ledwards2/P04-Purple/Demo Day/Marco/renders/Whole_Robot_2020-May-24_08-42-28AM-000_CustomizedView5941647607.png

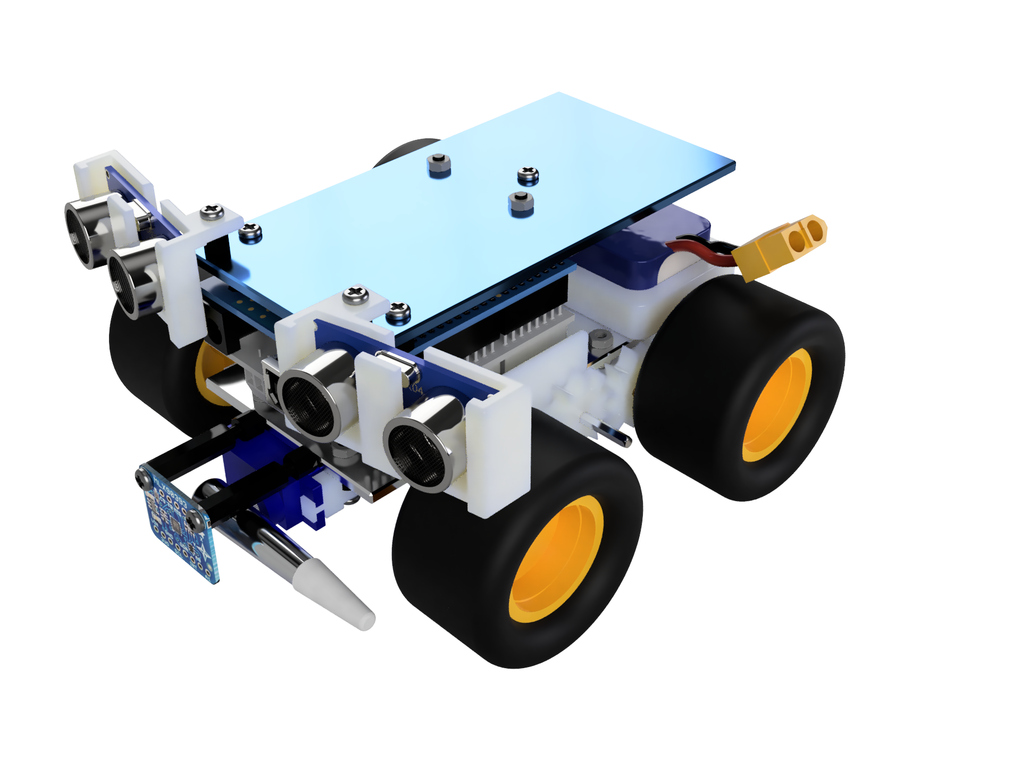
Demo Day/Marco/renders/Whole_Robot_2020-May-24_08-42-28AM-000_CustomizedView5941647607.png
