ledwards2/P04-Purple/Demo Day/Marco/renders/front.PNG

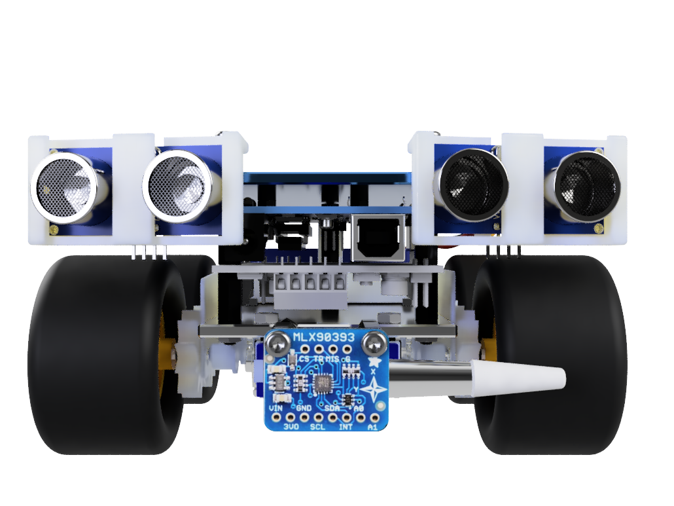
Demo Day/Marco/renders/front.PNG
