ledwards2/P04-Purple/README.md

# P04-Purple
ENGG1100 P04 Purple team repository
