ledwards2/P04-Purple/Code/info.txt

main.ino: main code for robot - to be used on demo day
test_movement.ino: basic code to test movement and turning of robot
test_sensors.ino: basic code to test sensors
