ledwards2/P04-Purple/Milestone_Files/Power System Justification.docx

The robot uses a Tamiya 70097 Twin Motor Gearbox, which uses to Mabuch Motor FA-130RA-18100 Motors (Pololu Corporation, n.d.).

These motors are powered between 1.5 and 3 volts, and at peak efficiency, they consume 0.56A at 9710 RPM. At stall, they consume 2.1A (Mabuchi Motor, n.d).

A 1A constant current draw will be assumed per motor.

A 10 minute total required run time will be assumed, to allow for testing and a five minute measured run.

The Arduino Uno will use around 50mA (http://www.gadgetmakersblog.com/arduino-power-consumption/).

Each ultrasonic sensor uses 15mA while working (https://randomnerdtutorials.com/complete-guide-for-ultrasonic-sensor-hc-sr04/), so a 30mA current draw for ultrasonic sensors is assumed. The Melexis MLX90393 Magnetometer uses a nominal current of 100 microamps (Melexis, 2020).

The marking system servo uses 100mA while moving with no load, which is similar to the desired use, where the servo motor moves only a paint brush. (https://www.addicore.com/FS90-Mini-Servo-p/ad113.htm)

The total current:

I_(total) =I_(motors) +I_(arduino) +I_(sensors) +I_(marking)

I_(motors) =2 , I_(arduino) =0.05 , I_(sensors) =0.015×2+0.0001=0.0301 and I_(marking) =0.1

The constant current draw is:

I_(total) =2+0.05+0.0301+0.1=2.1801

10 minute drive time is 1/6 hours

2.1801×1/6=0.36335Ah

The battery must supply at least 0.365335 amp-hours. The Arduino input voltage is from 7 to 12 volts and the motorshield input voltage is from 5 to 12 volts. A voltage input between this range must be supplied.

A 2 cell lithium polymer battery will be used. These have a voltage range from 8.4 to 6 volts, with a nominal voltage of 7.4. The required capacity is 364mAh. An 800mAh battery will be used, to allow extra headroom for variation from calculations, and since its weight is still low (59g).

Available at:

https://hobbyking.com/en_us/turnigy-800mah-2s-40c-lipo-pack.html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

It is important to note that the supplied motors and motor controller are not explicitly compatible, since the motors work at a lower voltage range than the motorshield. Where the input voltage is 8.4V:

3=8.4×%_(pwm)

%_(pwm) =36

Where an input PWM duty cycle 36% or over is input, the motor voltage range is exceeded, so this must be the maximum PWM input in software. The PWM voltage spikes should not pose any issue for motor longevity as the inductive quality of motor windings will smooth these out.
