ledwards2/P04-Purple/Milestone_Files/Drive system sketches.pdf

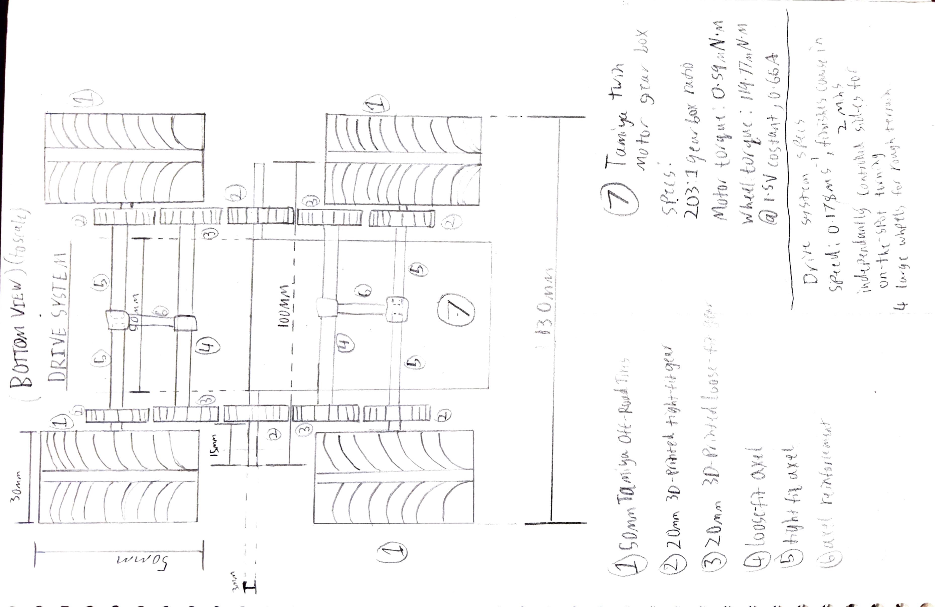
[picture p20: page 1]
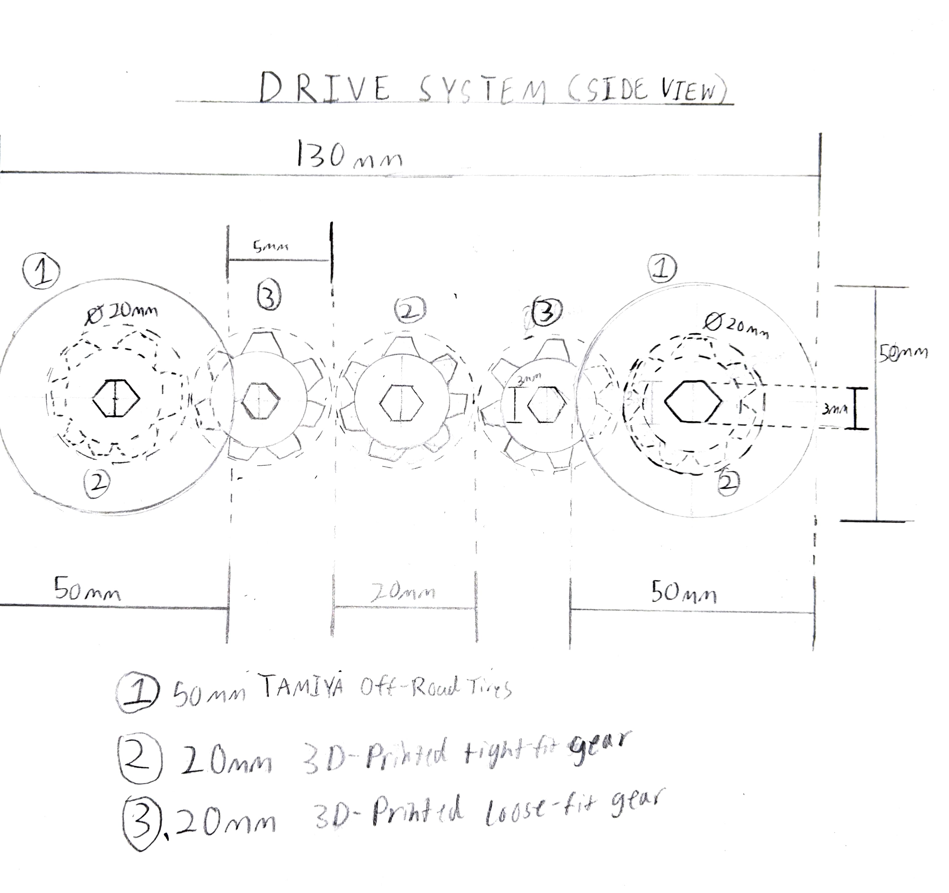
[picture p21: page 2]
