ledwards2/P04-Purple/Milestone_Files/centre of gravity calqs.pdf

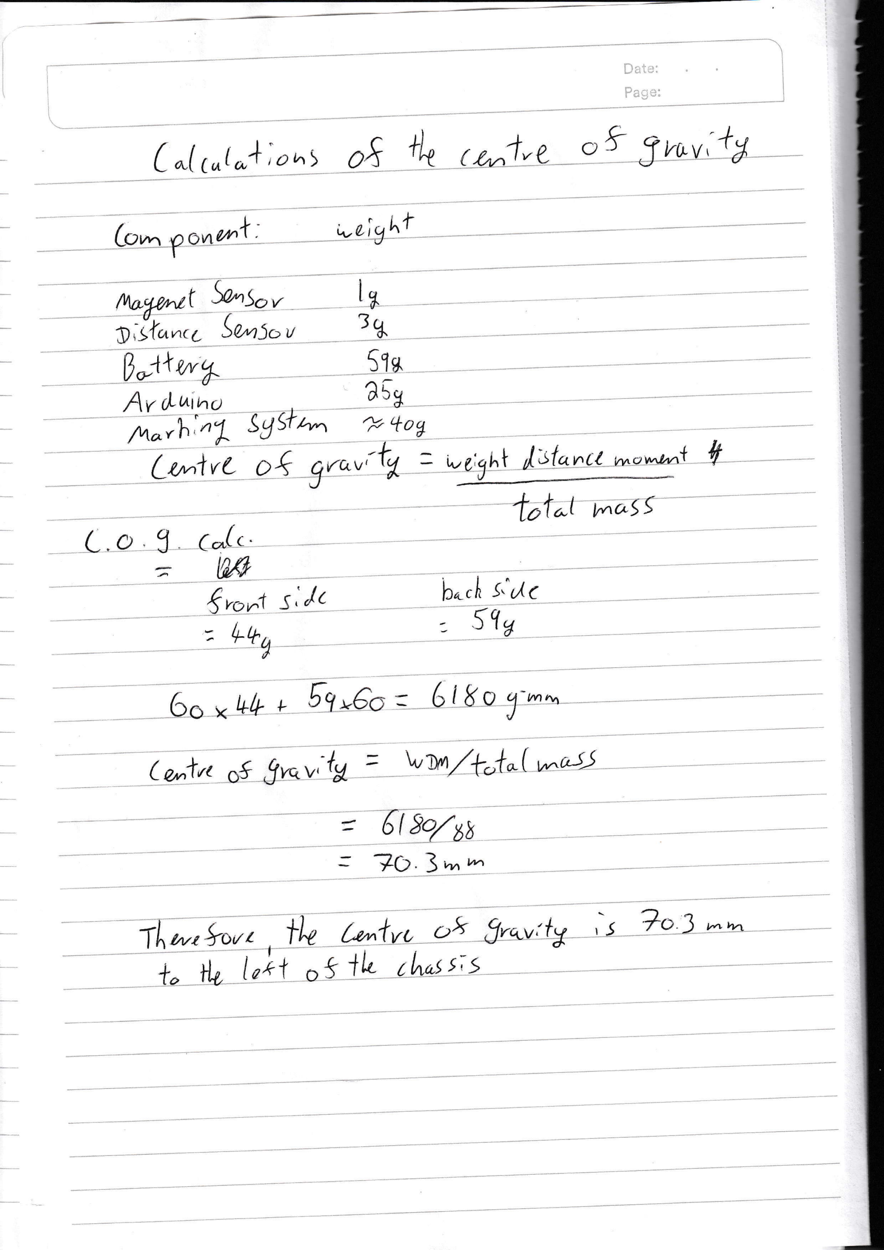
[picture p22: page 1]

D*l:;: | l
Pa!1,': | .-]
(*(u[*4)oa\ | o * ? ruv,"+,

Avd-t^inc) - .i--Jr
A;,T;T sgT?_k,+et

### -tat*-m"rr

---6s-xll*--6:,go-=*b!8*o-yr^-

VO-3^^

ln*t

t.^+ | s*
1l* | 5,
