ledwards2/P04-Purple/Milestone_Files/Marking System.pdf

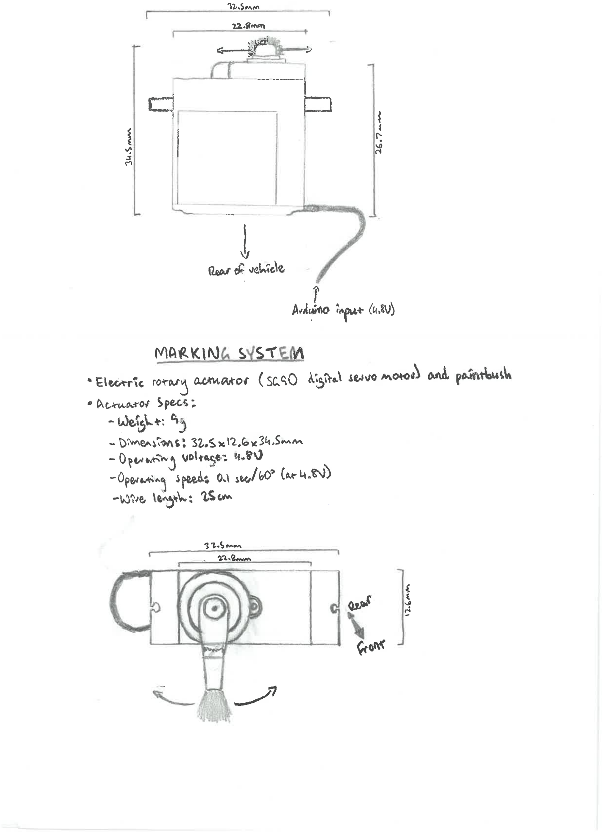
[picture p23: page 1]
