ledwards2/P04-Purple/Demo Day/Marco/renders/side.PNG

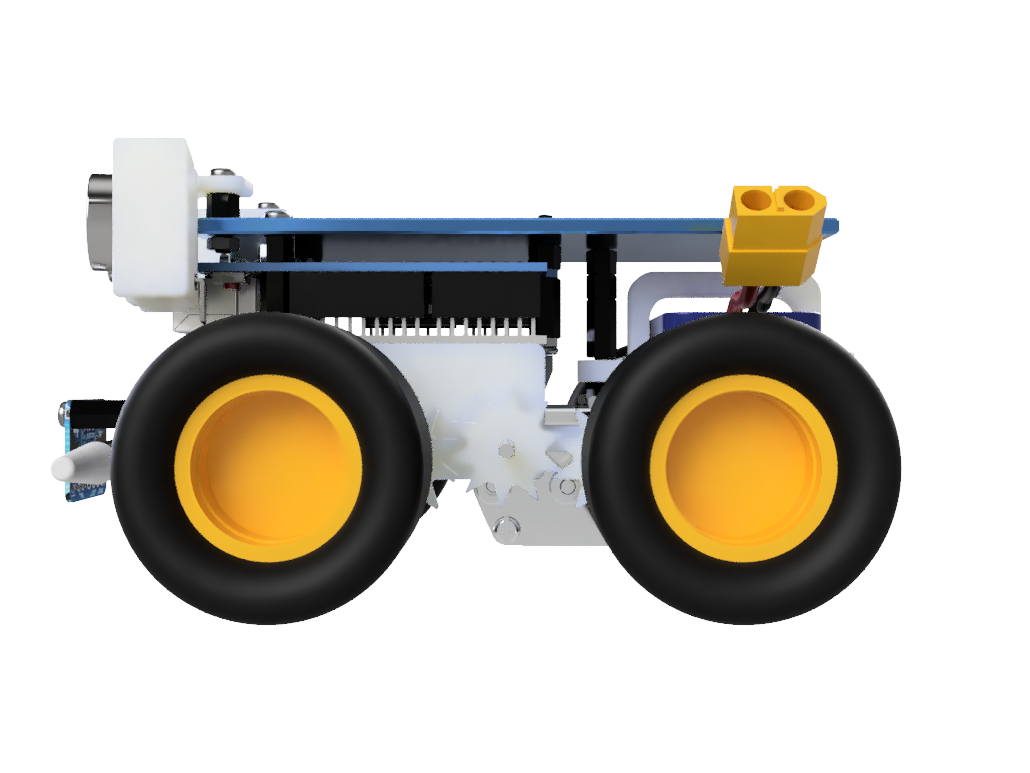
Demo Day/Marco/renders/side.PNG
