ledwards2/P04-Purple/Demo Day/Marco/renders/Whole_Robot_2020-May-28_04-46-54AM-000_CustomizedView5582573335.png

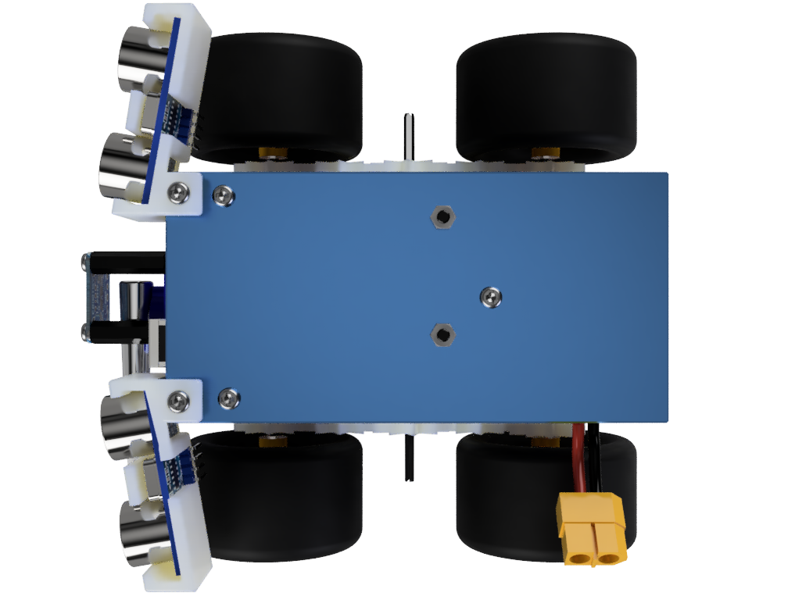
Demo Day/Marco/renders/Whole_Robot_2020-May-28_04-46-54AM-000_CustomizedView5582573335.png
