ledwards2/P04-Purple/Milestone_Files/Circuit Digram.png

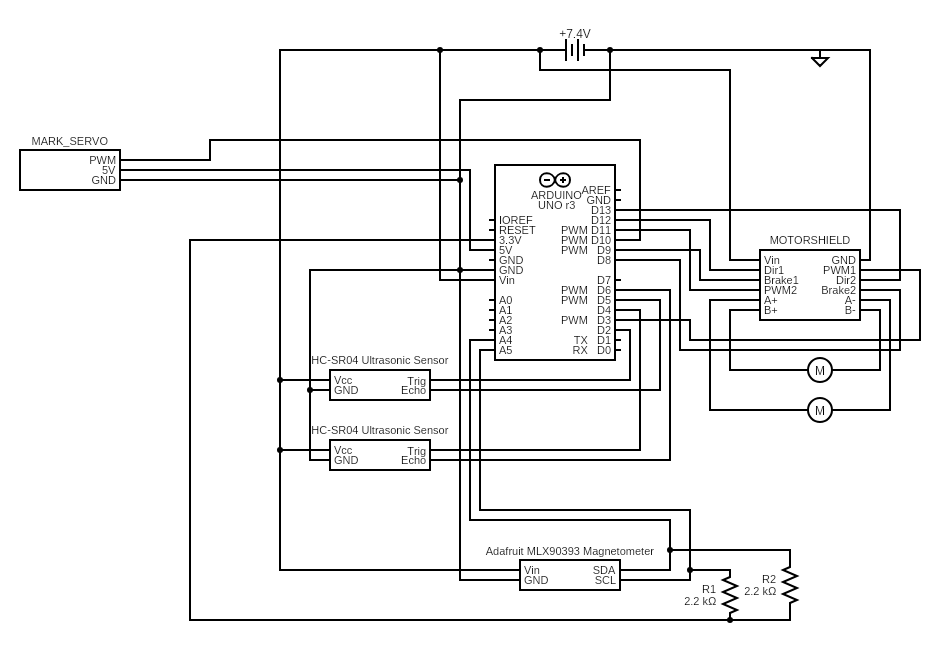
Milestone_Files/Circuit Digram.png
