ledwards2/P04-Purple/Milestone_Files/gear iso.png

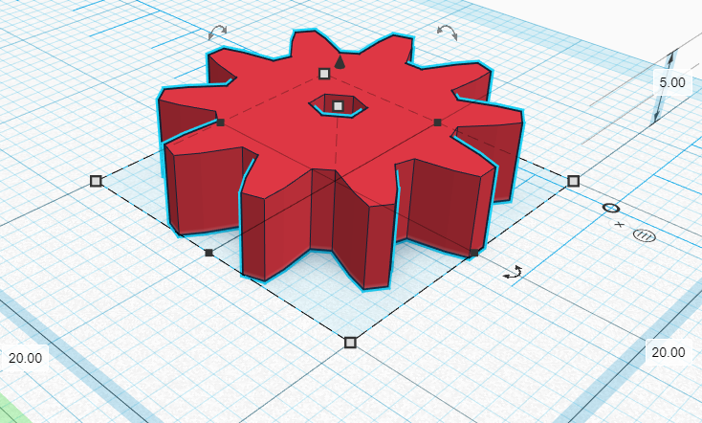
Milestone_Files/gear iso.png
