ledwards2/P04-Purple/Milestone_Files/gear top.png

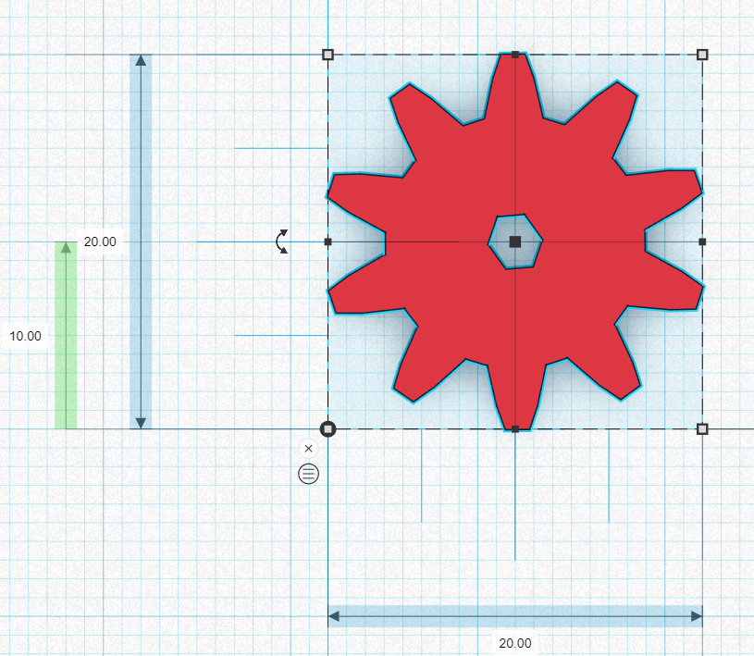
Milestone_Files/gear top.png
