ledwards2/P04-Purple/Milestone_Files/Layout Diagram.png

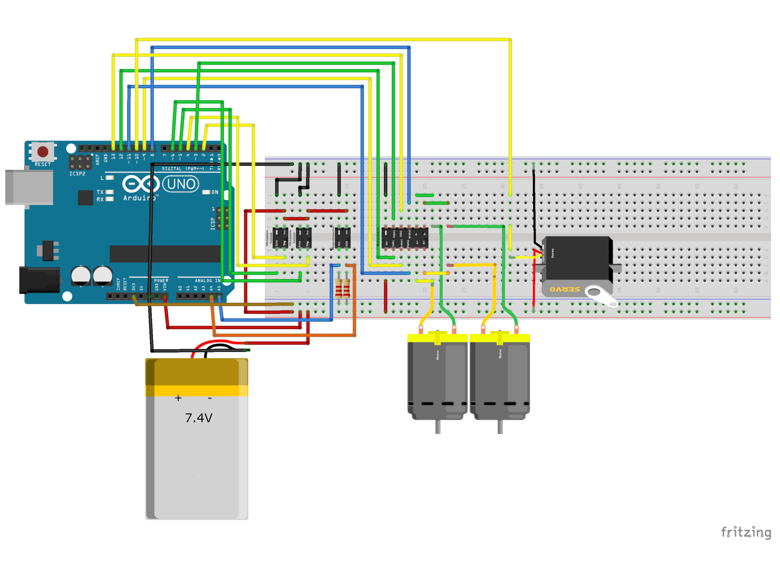
Milestone_Files/Layout Diagram.png
