ledwards2/P04-Purple/Gantt Chart and Resource Allocation.xlsx

TASK/SUBTASK |  | RESOURCES |  | 6 April, Wk 6 |  |  |  |  |  | 20 April, Wk 7 |  |  |  |  |  | 27 April, Wk 8 |  |  |  |  |  | 4 May, Wk 9 |  |  |  |  |  | 11 May, Wk 10 |  |  |  |  |  | 18 May, Wk 11 |  |  |  |  |  | 25 May, Wk 12 |  |  |  |  |  | 1 June, Wk 13
No. | Description | Hours | Who | M | T | W | T | F | S/S | M | T | W | T | F | S/S | M | T | W | T | F | S/S | M | T | W | T | F | S/S | M | T | W | T | F | S/S | M | T | W | T | F | S/S | M | T | W | T | F | S/S | M | T | W | T | F | S/S
1 | Basic Planning/Administrative Phase | 9
1.1 | Compare PIRs and establish design | 3 | Team
1.2 | Establish team roles | 1 | Team
1.3 | Distribute roles to best fit team member | 1 | Team
1.4 | Basic design sketch | 3 | Joseph
1.5 | Allocate budget | 1 | Team
2 | Subsystem Design Phase | 35
2.1 | Develop WBS for each subsystem | 2 | Team
2.2 | Marking system design | 9
2.2.1 | Choose marker type | 2 | Joseph
2.2.2 | Rough physical design | 1 | Joseph
2.2.3 | Choose components | 3 | Joseph
2.2.4 | CAD drawing of design | 3 | Joseph
2.3 | Mechanical Design | 7
2.3.1 | Research provided gearbox | 1 | Abhishekh
2.3.2 | Choose travelling method | 1 | Abhishekh
2.3.3 | Choose appropriate materials for chassis | 1 | Luke
2.3.4 | Design chassis | 2 | Luke
2.3.5 | Choose components and write specification | 2 | Abhishekh
2.4 | Electrical Design | 5
2.4.1 | Research provided sensors | 1 | Lachlan
2.4.2 | Choose power system | 1 | Abhishekh
2.4.3 | Choose sensors | 1 | Joseph
2.4.4 | Circuit diagram for whole robot | 2 | Luke
2.5 | Software | 12
2.5.1 | Choose search algorithm | 2 | Lachlan
2.5.2 | Write function to communicate with sensors | 4 | Lachlan
2.5.3 | Choose activation threshold for sensors | 1 | Lachlan
2.5.4 | Write main code | 5 | Lachlan
3 | Subsystem Integration Phase | 7
3.1 | Bring subsystem designs together | 7
3.1.1 | Consider component interconnections | 3 | Team
3.1.2 | Modify so that subsystems work together | 4 | Team
4 | Purchasing Phase | 4
4.1 | Write parts list for whole robot | 1 | Joseph
4.2 | Check all costs are within budget | 1 | Luke
4.3 | Modify component selection if needed | 2 | Team
5 | Build Phase | 19
5.1 | Develop WBS for build process | 1 | Luke
5.2 | Build as per breakdown | 10 | Team
5.3 | Test components individually | 5 | Team
5.4 | Connect components together | 3 | Team
6 | Testing Phase | 8
6.1 | Test in environment similar to Demo Day | 4 | Team
6.2 | Modify or redesign as needed | 4 | Team
M | Team Meetings | 2/wk |  |  |  |  |  |  |  |  |  |  |  |  |  |  |  |  |  |  |  |  |  |  |  |  |  |  |  |  |  |  |  |  |  |  |  |  |  |  |  |  |  |  |  | DD |  |  | FR
M | Submission Due | N/A |  |  |  | PSP |  |  |  |  |  |  |  |  |  |  |  |  |  |  |  |  |  | MT |  |  |  |  |  |  | LB
M | Templates | 1/pt |  | F |  |  |  |  |  | G |  |  | H |  |  | I |  |  | J |  |  | K
