ledwards2/P04-Purple/WBS - 3 Apr.xlsx

Work Breakdown Structure
SAP PROJECT SYSTEM |  |  |  |  |  |  |  |  |  |  |  | OTHER PROJECT TOOLS
Level 1 WBS |  |  |  |  |  | Autonomous Landmine Sweeper
Level 2 WBS | Basic Planning / administrative Phase | Subsystem Design Phase | Marking System Design Phase | Drive System Design Phase | Sensors Design / Electrical Configuration | Software | Subsystem Integration Phase | Purchasing Phase | Build Phase | Testing Phase | Project Name
Level 3 WBS | Preliminary Work Plan | Design of discipline specific parts | Choose marker type | Research provided motor/gearbox | Research provided sensors | Choose search algorithm | Compare design plans/CAD models and collaborate | Write parts list for whole robot | Person/people responsible for each role build respective component | Test robot with all subsystems connect, in environments similar to demo day | Phase
 | Compare PIRs | Refer to relevant PIR | Rough physical design of marking system | Choose propulsion type - wheels, tracks, etc | Choose power system, voltage regulator (if needed) | Write function to communicate with sensors | Consider interconnections between components eg. Communication protocol | Check all costs are within budget | Develop breakdown of build work to be completed | Test with similar environments to Demo Day eg. With magnets, walls,
 |  |  |  |  |  |  |  |  |  |  | Task
 | Establish Team Roles | Develop WBS for task eg. Software WBS | Choose actuator and electrical components | Work with chassis developer for wheel spacing etc | Choose sensors | Choose activation threshold for sensors | Make necessary modifications so that subsystems work together as needed | Modify component selection if needed | Build as per breakdown | Make modifications or redesign as necessary
 | Distribute roles to best fit team member | Design as per specific WBS | CAD design of marking system | Choose components and write specification for drive system | Circuit diagram for whole robot | Write main code |  |  | Test components individually
 | Basic Design Sketch | Develop CAD model or software code |  |  |  |  |  |  | Connect components together
 | Allocate budget
