ledwards2/P04-Purple/Milestone_Files/Wiring-layout-3.pdf

1

A

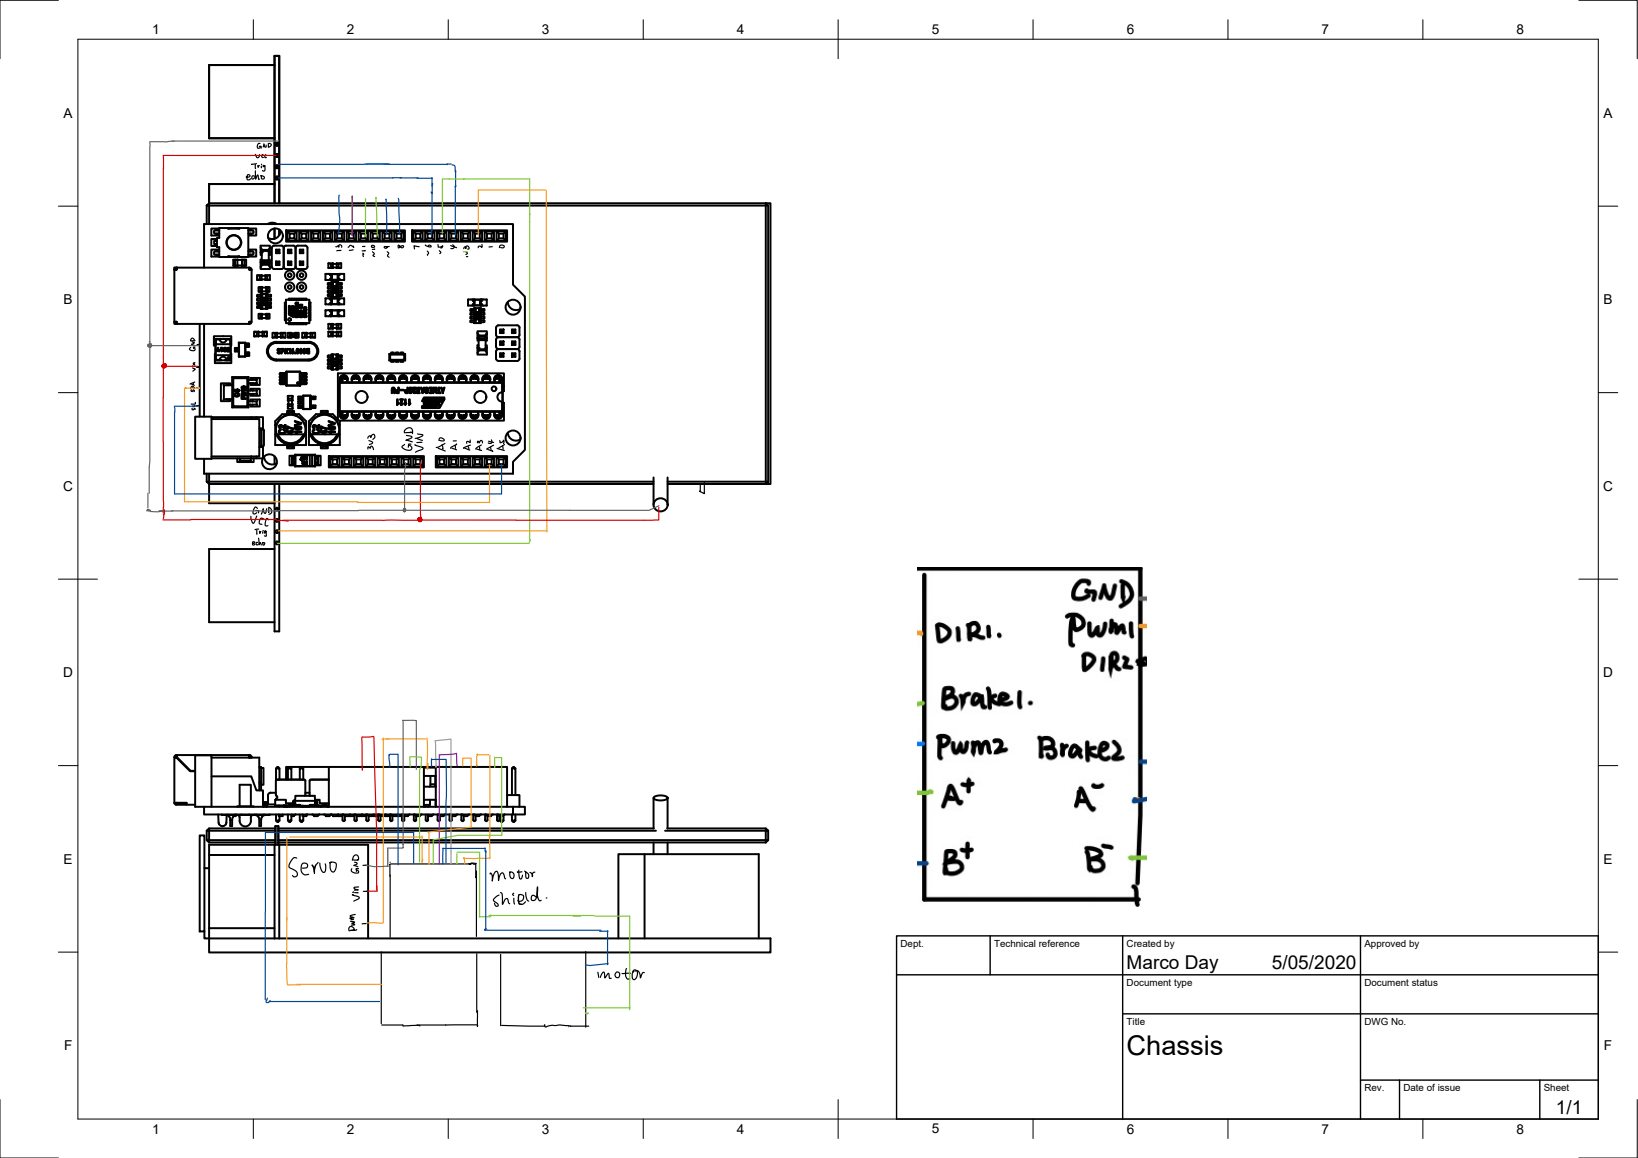
[picture p30: page 1]
Dept.; Technical reference; Created by; Approved by; Document type; Document status; Marco Day; iii.÷; # motor

Title Chassis | DWG No.

Rev. | Date of issue | Sheet 1/1
