ledwards2/P04-Purple/Milestone_Files/Wiring-layout-2.pdf

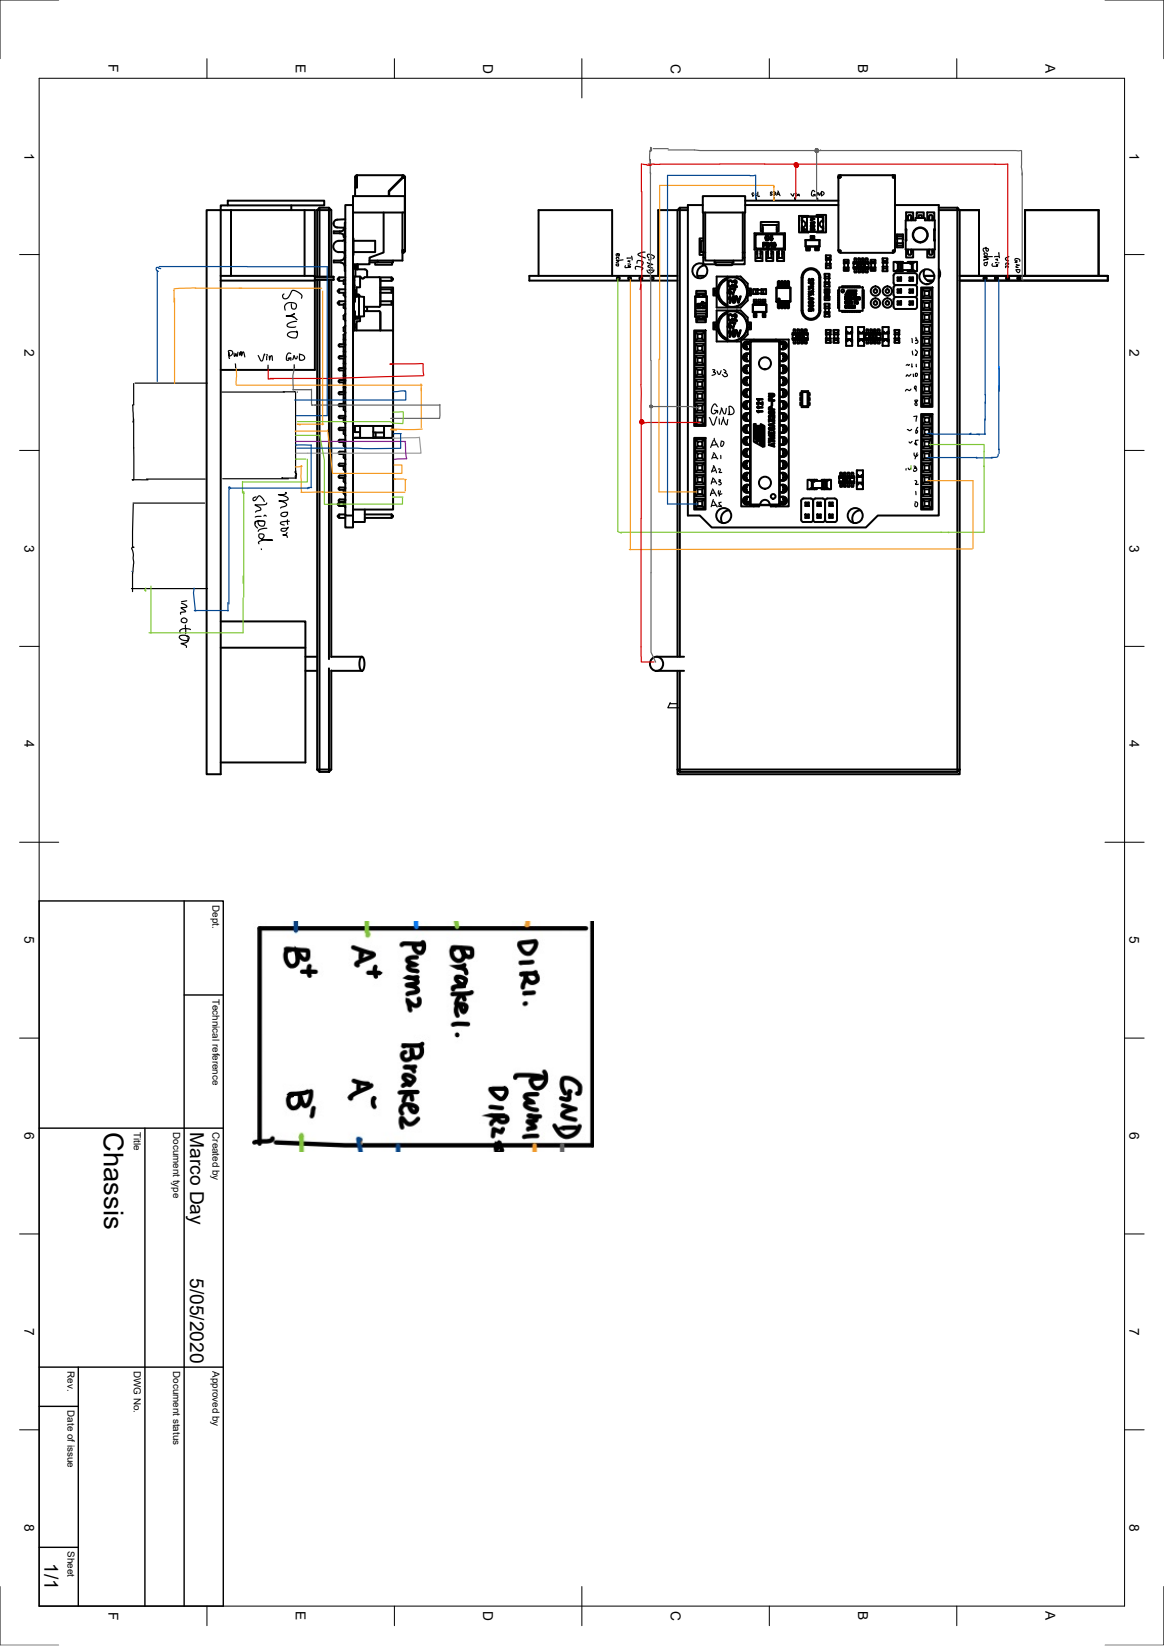
[picture p31: page 1]
Title; Rev.; DWG No.; Chassis; Marco Day; # motor

Dept. Technical reference Created by Approved by

Document type Document status

Date of issue Sheet
