ledwards2/P04-Purple/Demo Day/Marco/Chassis Drawing.pdf

19 | 20.5 | 7.85 62.9 1 5.75 9.15 61.6

29 15.5

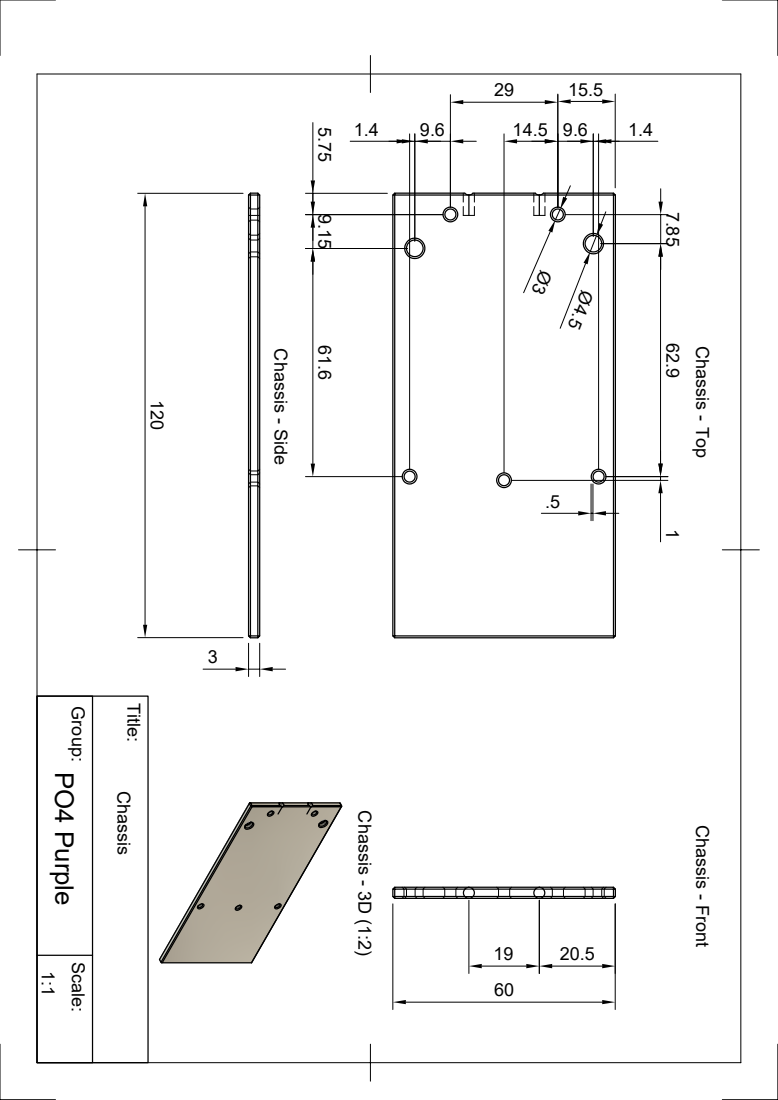
[picture p32: page 1]
60 ¹²⁰; .5 Chassis - Side; Chassis - Front Chassis - Top Chassis - 3D (1:2)

Group: Scale: Title: PO4 Purple Chassis 1:1
