ledwards2/P04-Purple/Milestone_Files/Battery Dimensions.pdf

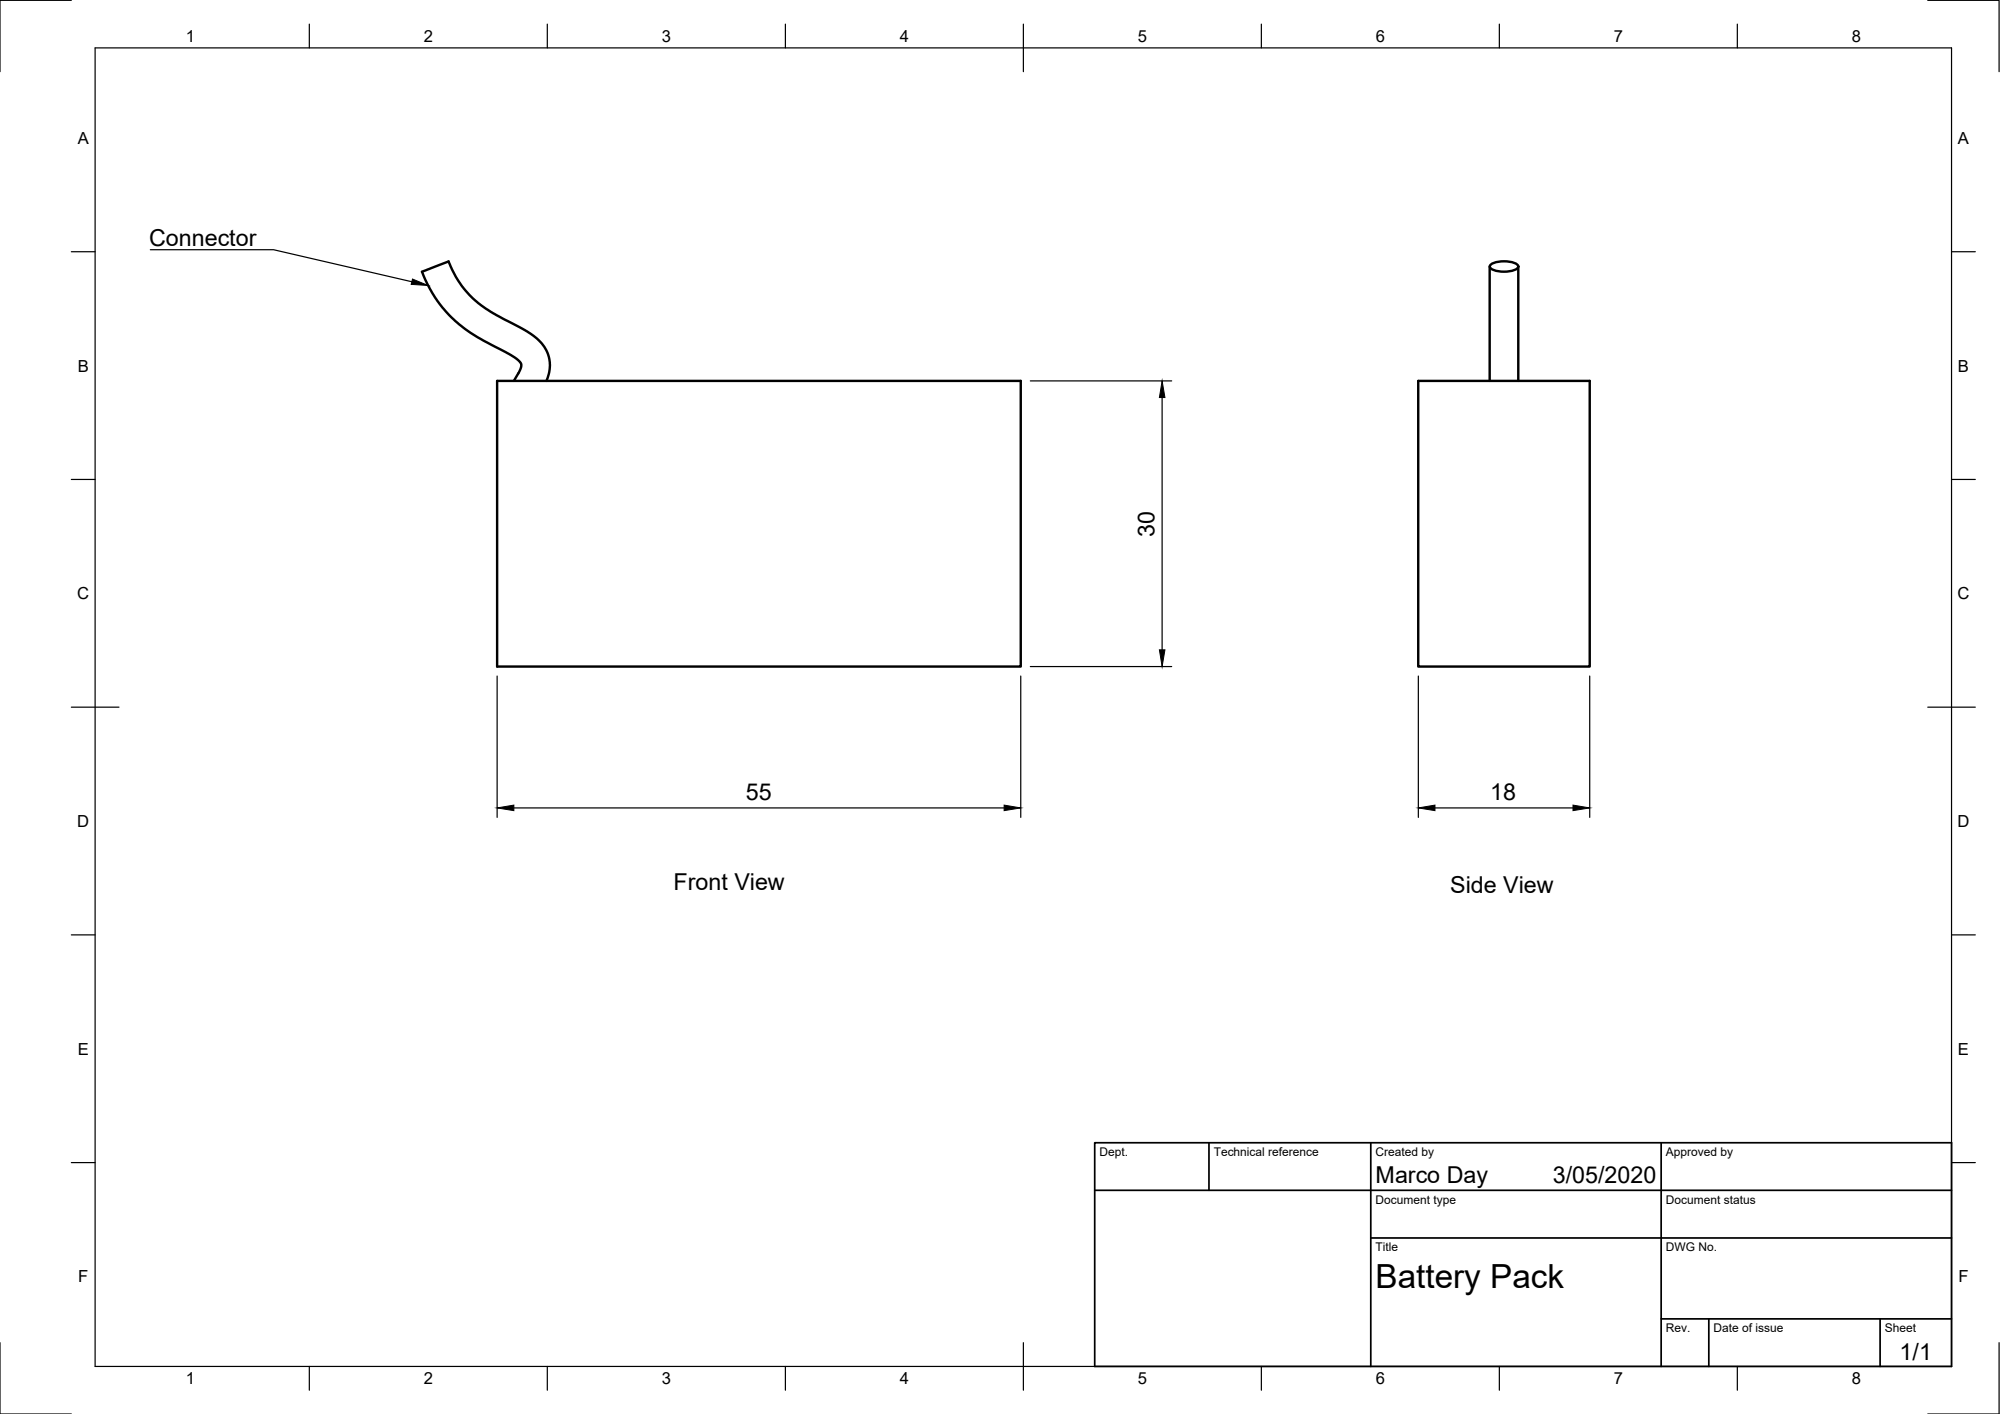
[picture p34: page 1]
Front View; Side View

Dept. | Technical reference | Created by Marco Day 3/05/2020 | Approved by

Document type | Document status

Title Battery Pack | DWG No.

Rev. | Date of issue | Sheet 1/1
