ledwards2/P04-Purple/Milestone_Files/Magnetometer Dimensions.pdf

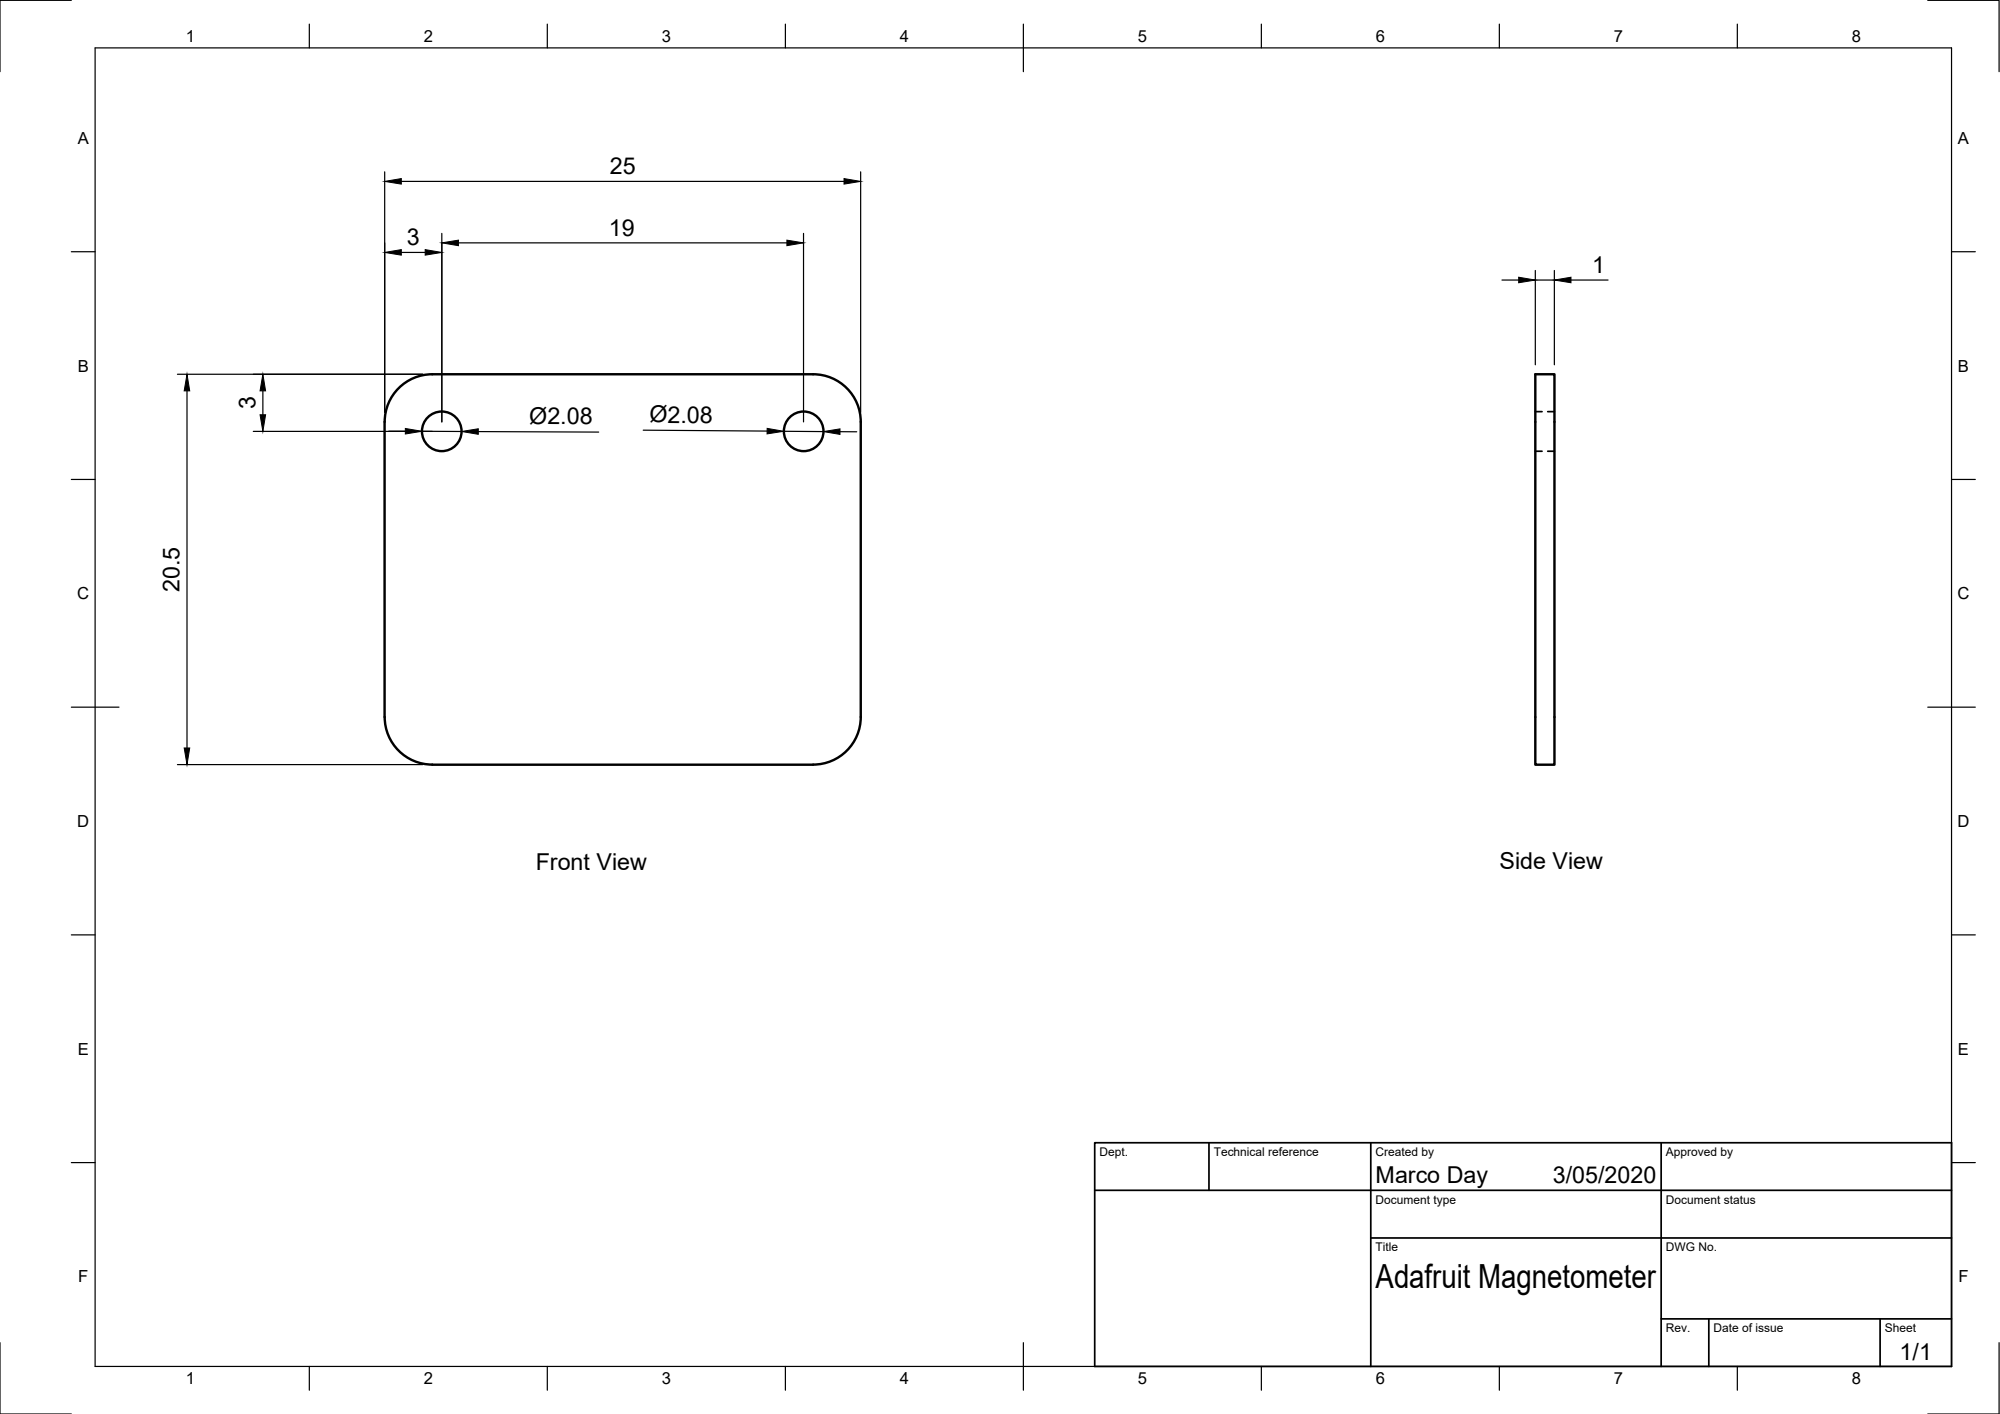
[picture p35: page 1]
Front View; Side View

Dept. | Technical reference | Created by Marco Day 3/05/2020 | Approved by

Document type | Document status

Title Adafruit Magnetometer | DWG No.

Rev. | Date of issue | Sheet 1/1
