ledwards2/P04-Purple/Milestone_Files/Ultrasonic Dimensions.pdf

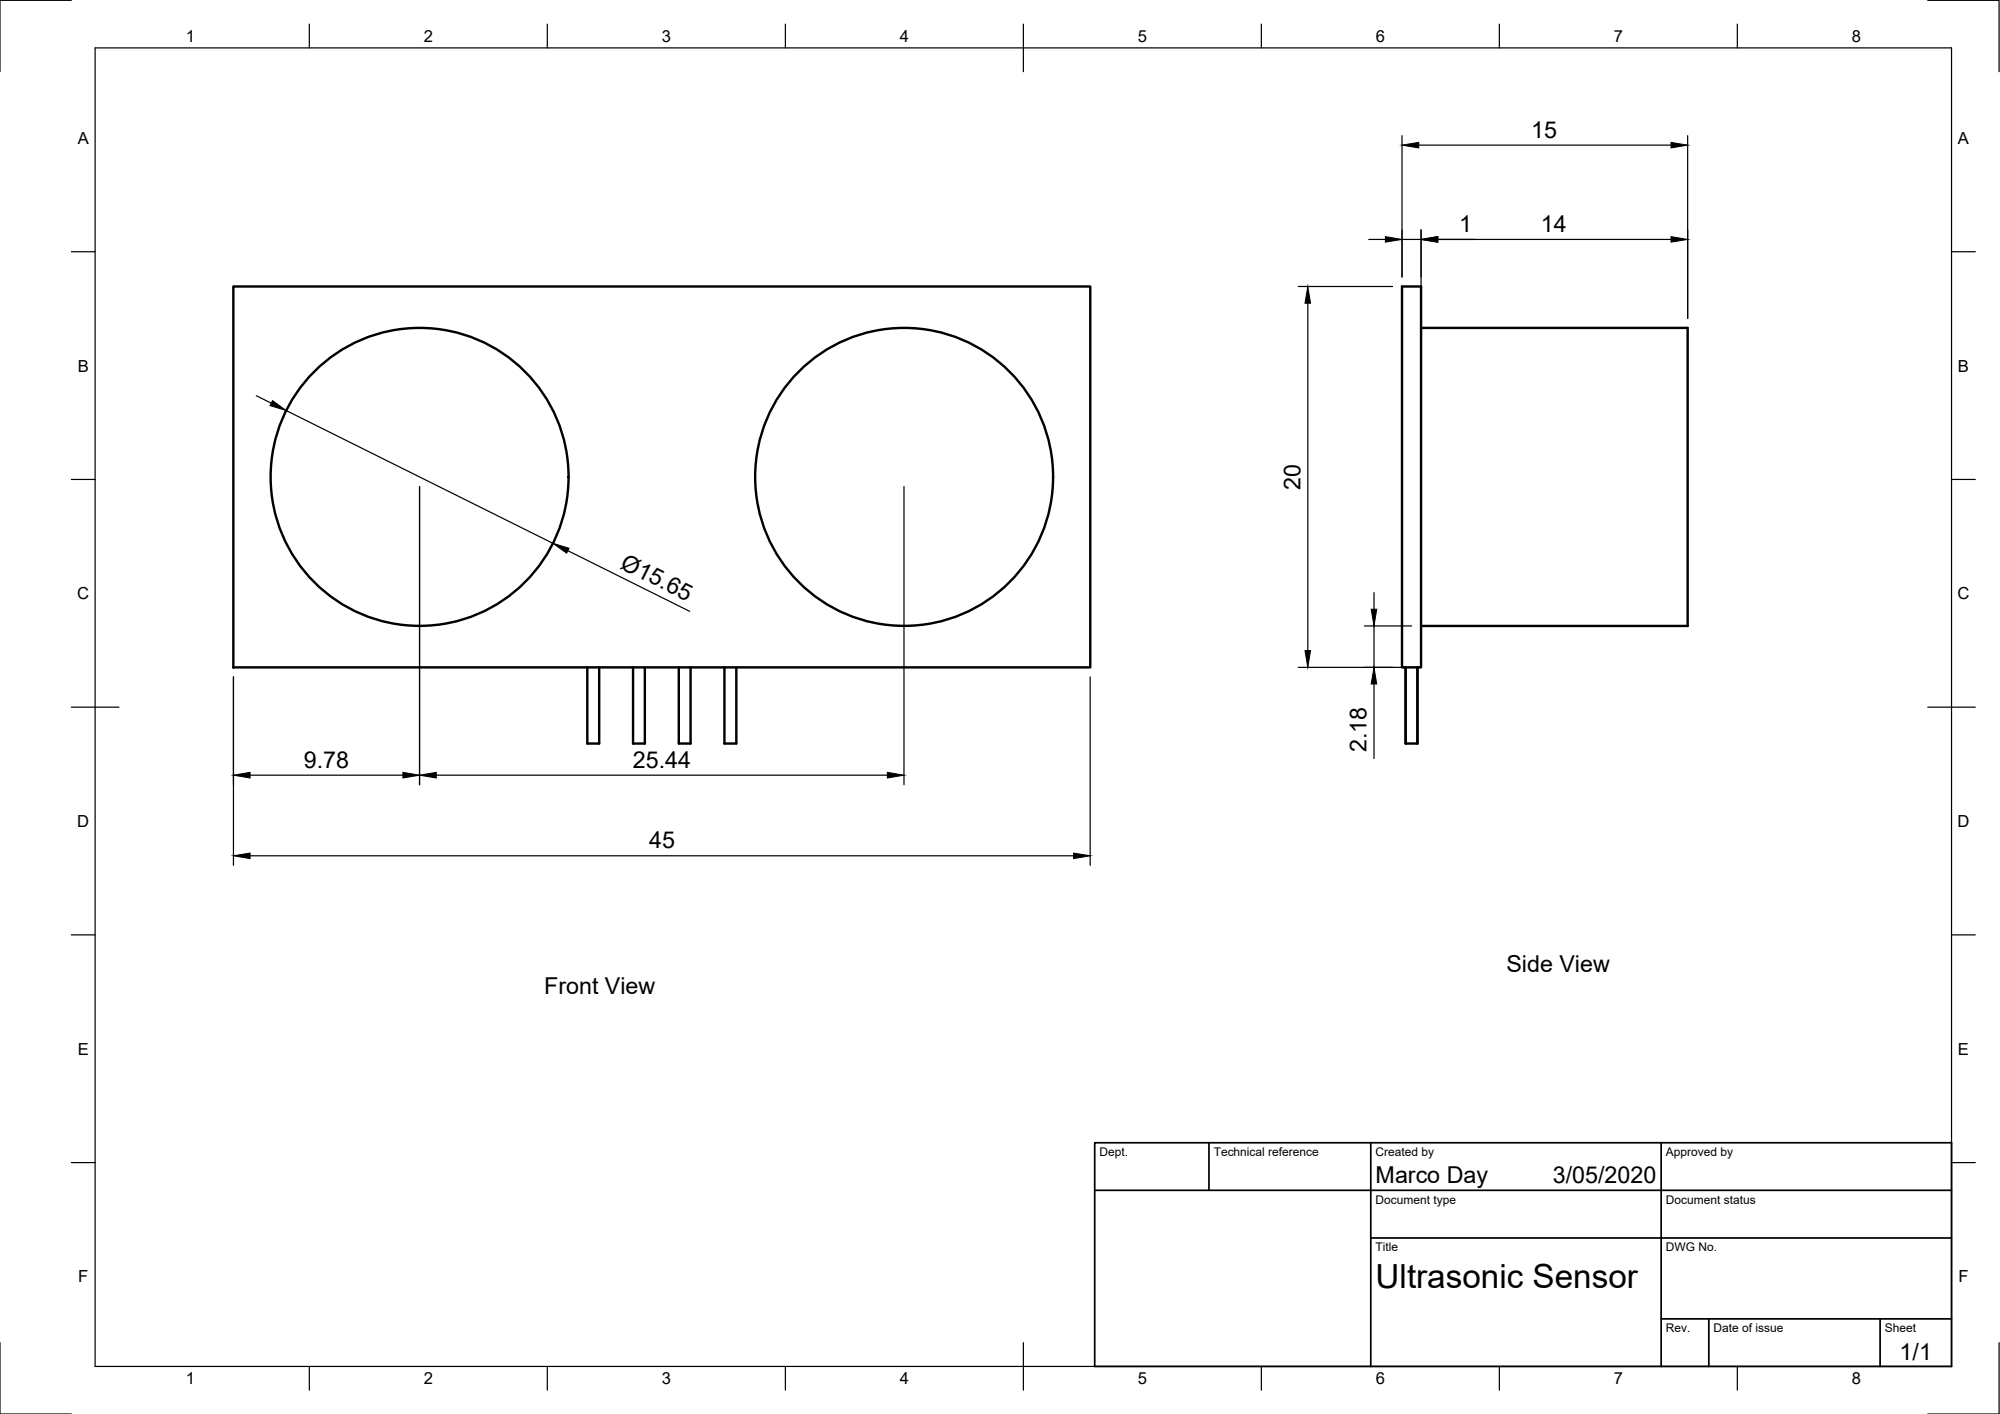
[picture p36: page 1]
Side View; Front View

Dept. | Technical reference | Created by Marco Day 3/05/2020 | Approved by

Document type | Document status

Title Ultrasonic Sensor | DWG No.

Rev. | Date of issue | Sheet 1/1
