ledwards2/P04-Purple/Demo Day/Marco/Ultrasonic Sesnsor Bundle Drawing.pdf

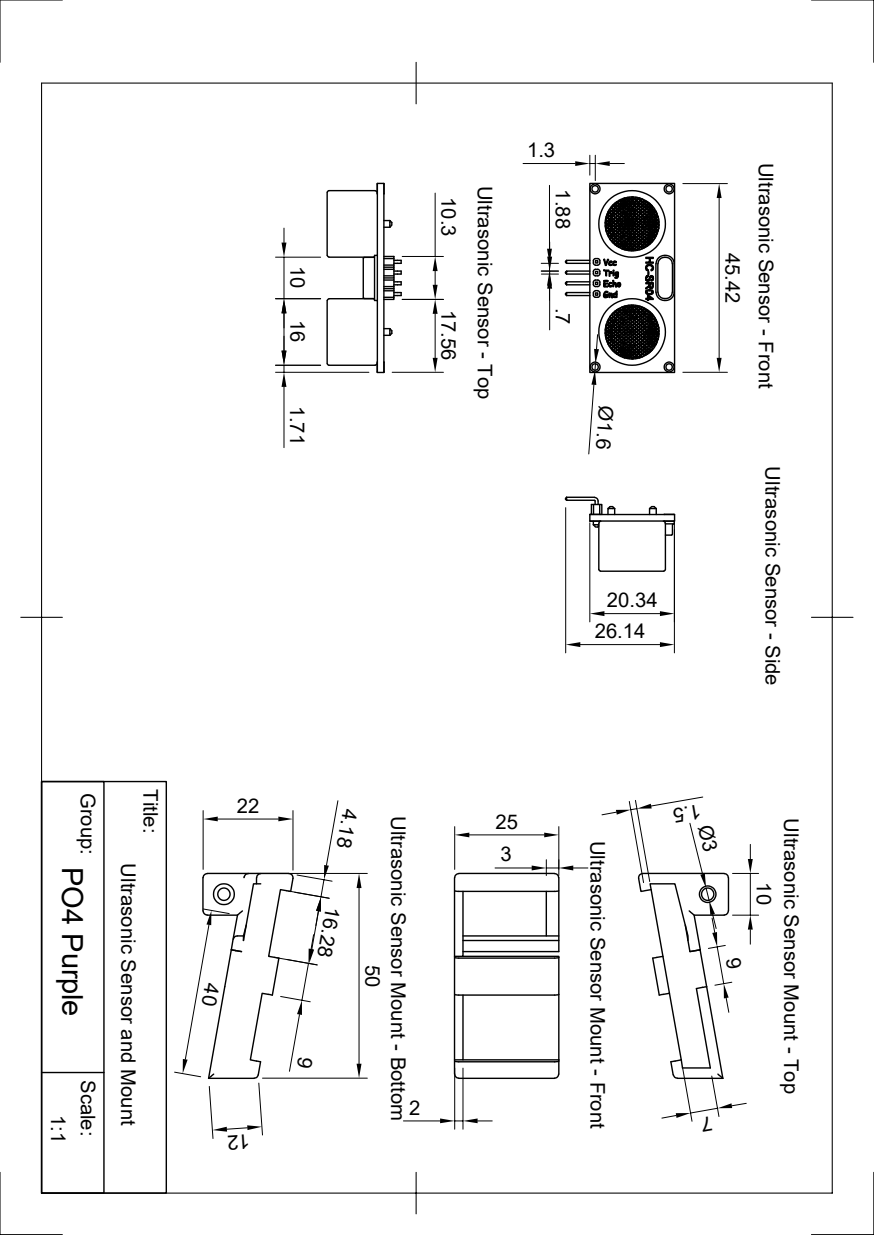
[picture p37: page 1]
Ultrasonic Sensor Mount - Top Ultrasonic Sensor Mount - Front Ultrasonic Sensor Mount - Bottom; Ultrasonic Sensor - Top; Ultrasonic Sensor - Front Ultrasonic Sensor - Side 1:1; Ultrasonic Sensor and Mount

Group: Scale: Title: PO4 Purple 50 16.28 9
