ledwards2/P04-Purple/Demo Day/Marco/Bottom.pdf

.97 18.78 41.6 7

8.97

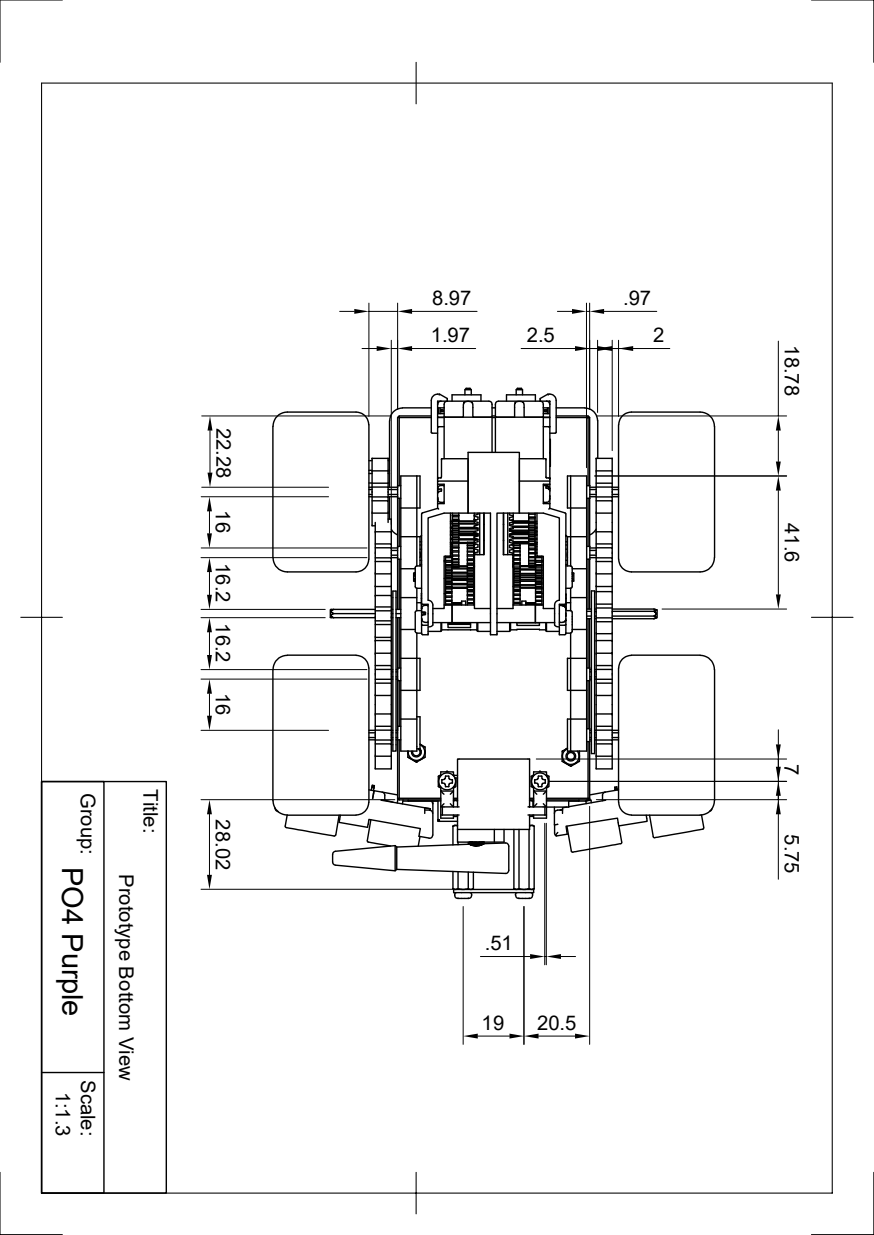
[picture p38: page 1]

Group: Scale: Title: PO4 Purple 1:1.3 Prototype Bottom View 5.75
