ledwards2/P04-Purple/Demo Day/Marco/Drive System.pdf

20 5 | Ø25 1

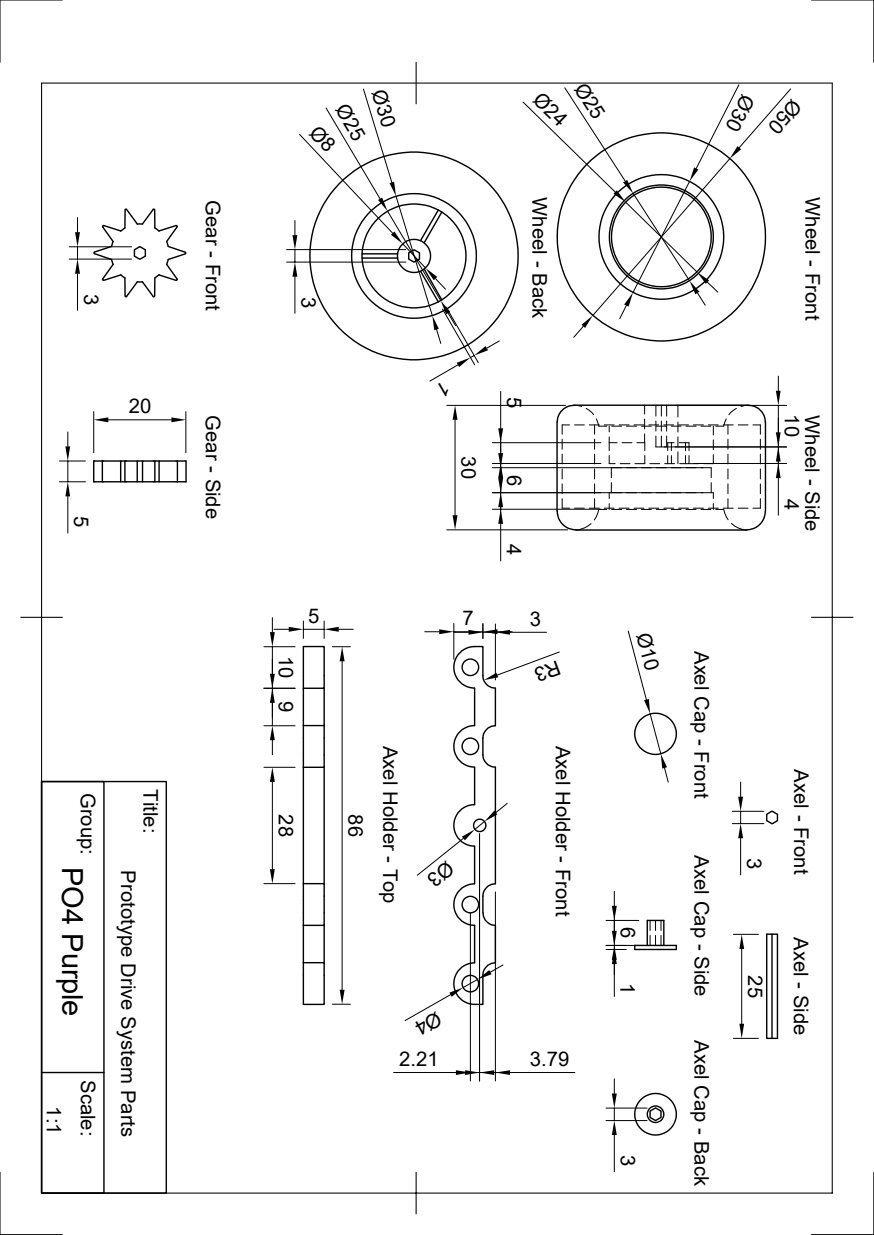
[picture p39: page 1]
Wheel - Front 1; Wheel - Side Wheel - Back Axel Holder - Top; Axel Holder - Front; Axel - Front Axel - Side 3 25 Ø10 6 3; Axel Cap - Front Axel Cap - Side Axel Cap - Back Gear - Front Gear - Side 3

Group: Scale: Title: PO4 Purple Ø24 Ø30 Ø50 30 Ø30 Ø25 Ø8 3 10 4 6 4 5 1:1 Prototype Drive System Parts Ø4 Ø3 R3
