ledwards2/P04-Purple/Demo Day/Marco/Side.pdf

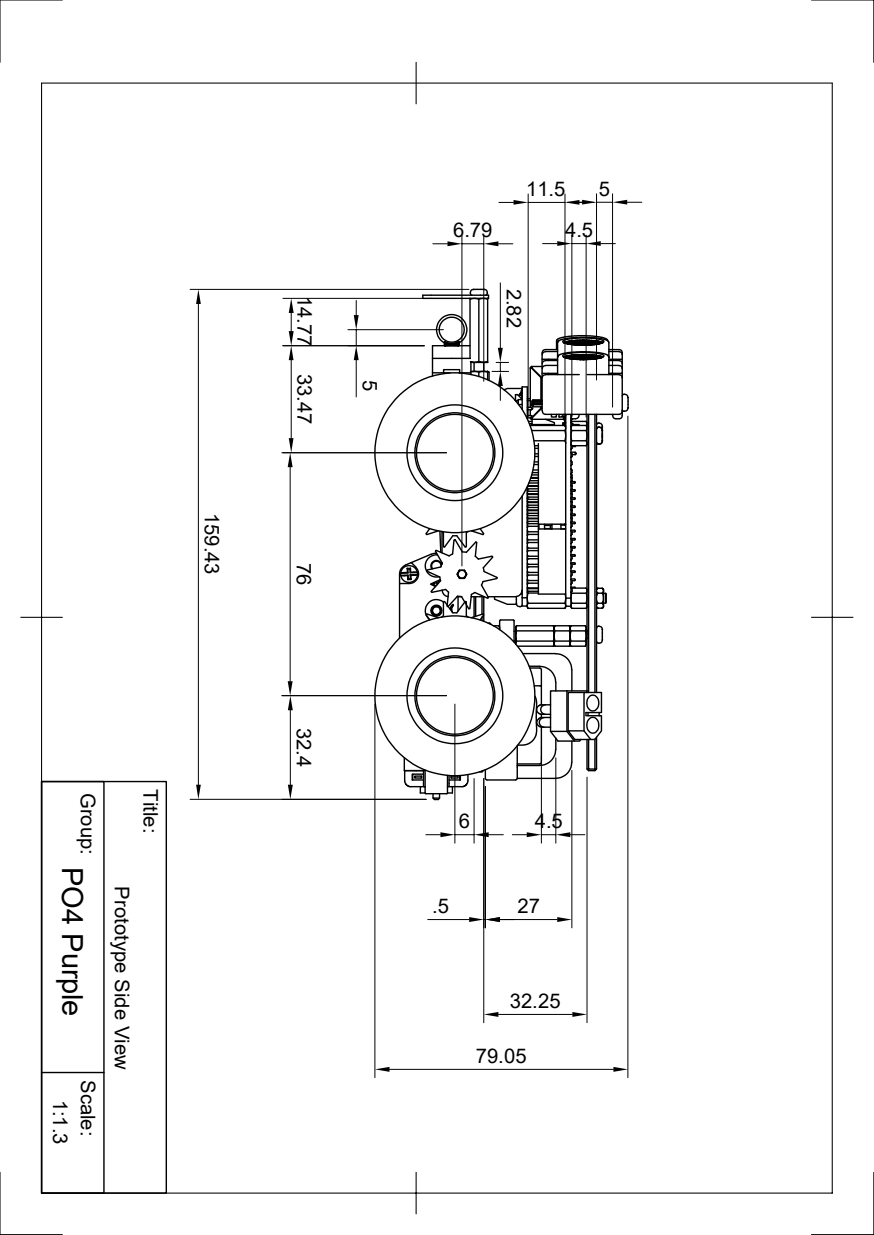
[picture p40: page 1]

Group: Scale: Title: PO4 Purple 159.43 1:1.3 Prototype Side View
