ledwards2/P04-Purple/Demo Day/Marco/Top.pdf

5.9 10°

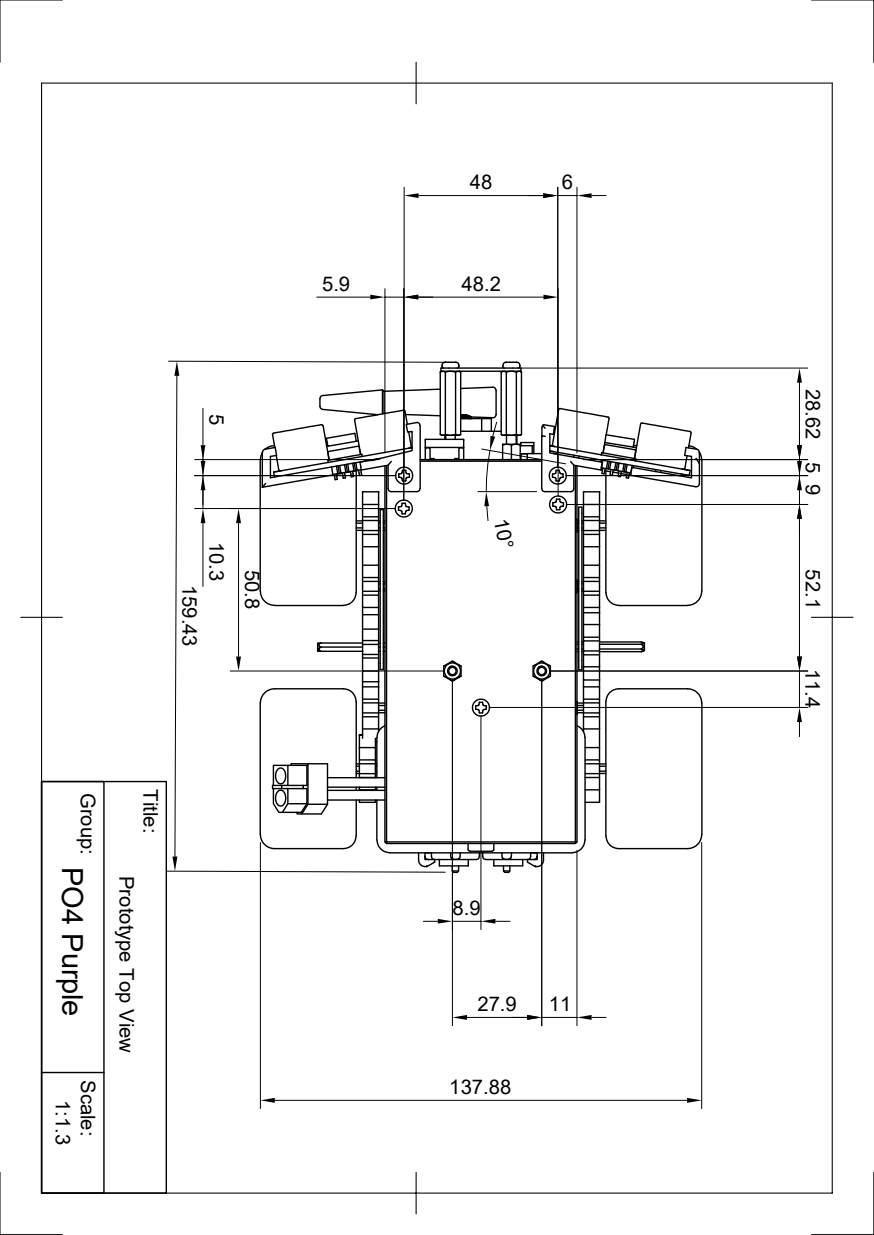
[picture p41: page 1]

Group: Scale: Title: PO4 Purple 159.43

8.9 Prototype Top View 1:1.3
