ledwards2/P04-Purple/Demo Day/Marco/Drawings/Drawing_arduino_and_motor_shield.pdf

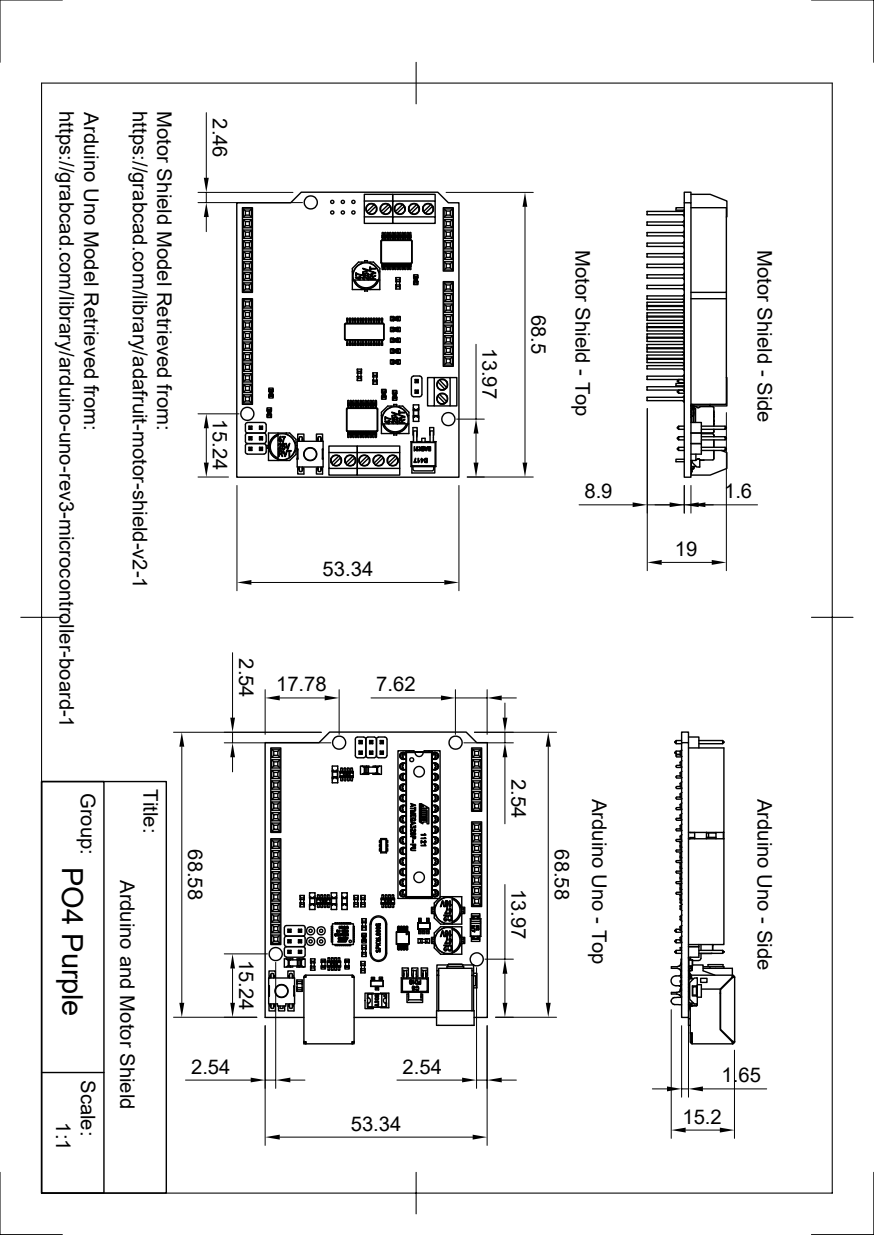
[picture p42: page 1]
15.2 Arduino and Motor Shield; 1.6 Motor Shield - Top; Motor Shield - Side Arduino Uno - Top; Arduino Uno - Side https://grabcad.com/library/arduino-uno-rev3-microcontroller-board-1 Arduino Uno Model Retrieved from:; https://grabcad.com/library/adafruit-motor-shield-v2-1 Motor Shield Model Retrieved from:

Group: Scale: Title: PO4 Purple 68.58 2.54 13.97 2.54 15.24
