ledwards2/P04-Purple/Demo Day/Marco/Drawings/Drawing_Battery_system.pdf

# 18 R5

30 16.7

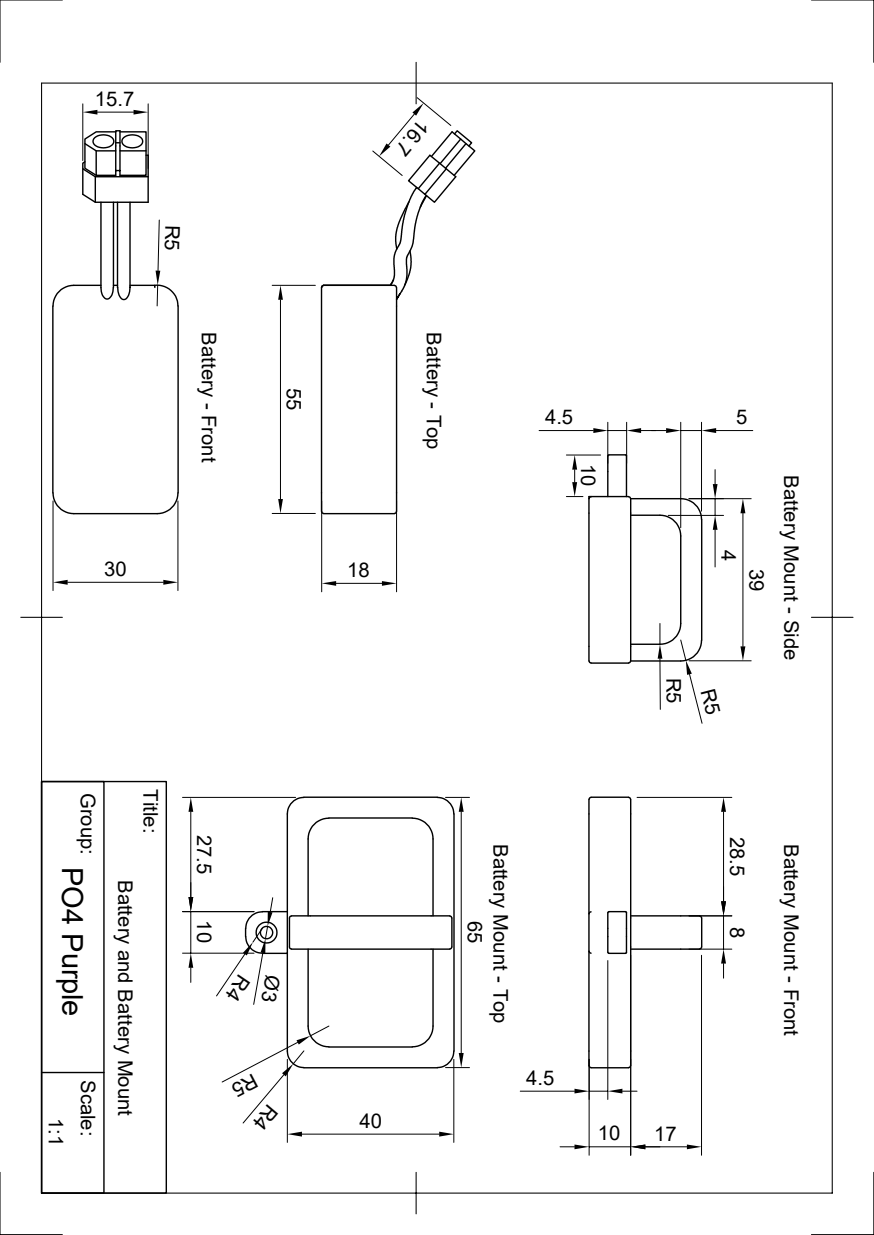
[picture p43: page 1]
Battery - Front; Battery - Top 10; Battery Mount - Side Battery Mount - Top; Battery Mount - Front Battery and Battery Mount1:1

Group: Scale: Title: PO4 Purple 55
