ledwards2/P04-Purple/Demo Day/Marco/Drawings/Drawing_Drive_system_gear_box.pdf

51

102

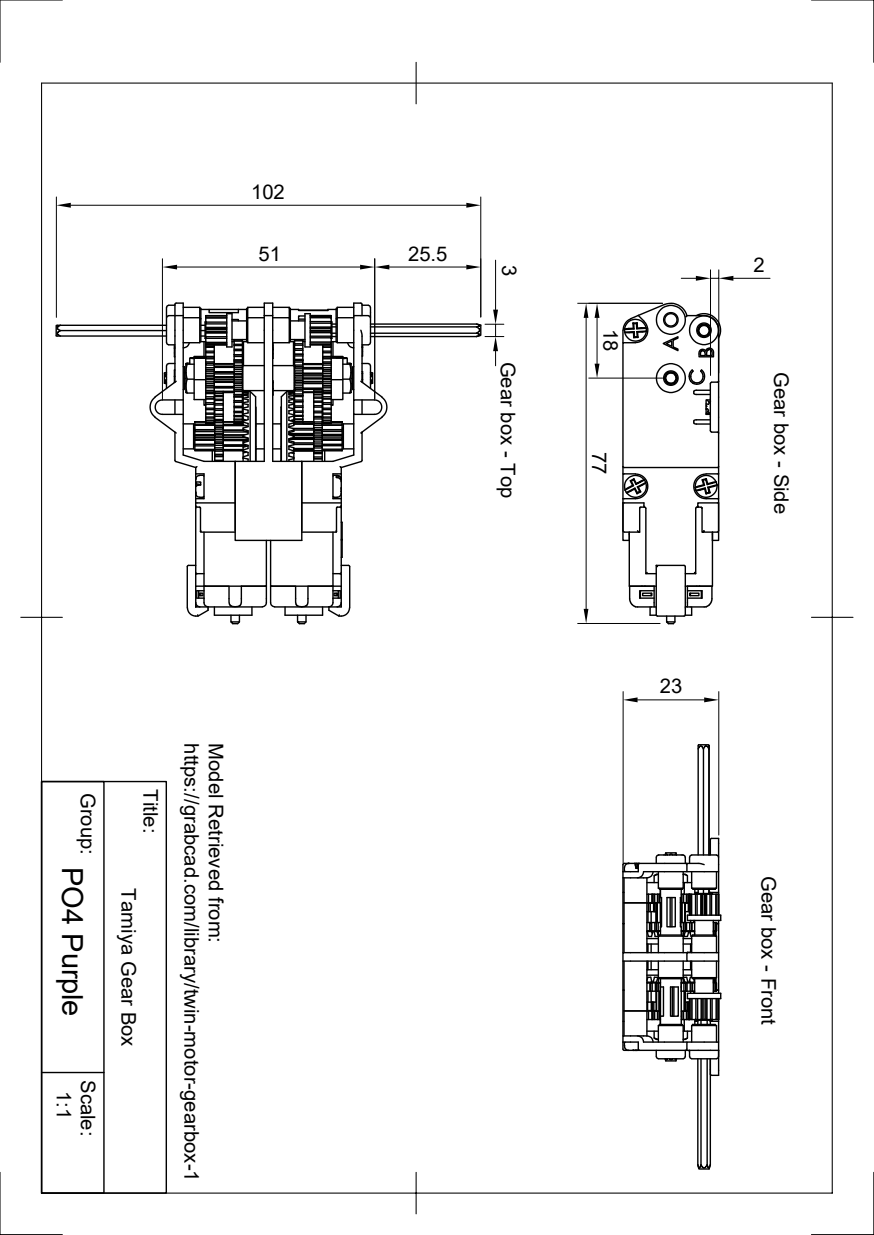
[picture p44: page 1]
Gear box - Side Gear box - Front Gear box - Top 3 Tamiya Gear Box 1:1; https://grabcad.com/library/twin-motor-gearbox-1 Model Retrieved from:

Group: Scale: Title: PO4 Purple
