ledwards2/P04-Purple/Demo Day/Marco/Drawings/Drawing_Magnetometer_and_screws.pdf

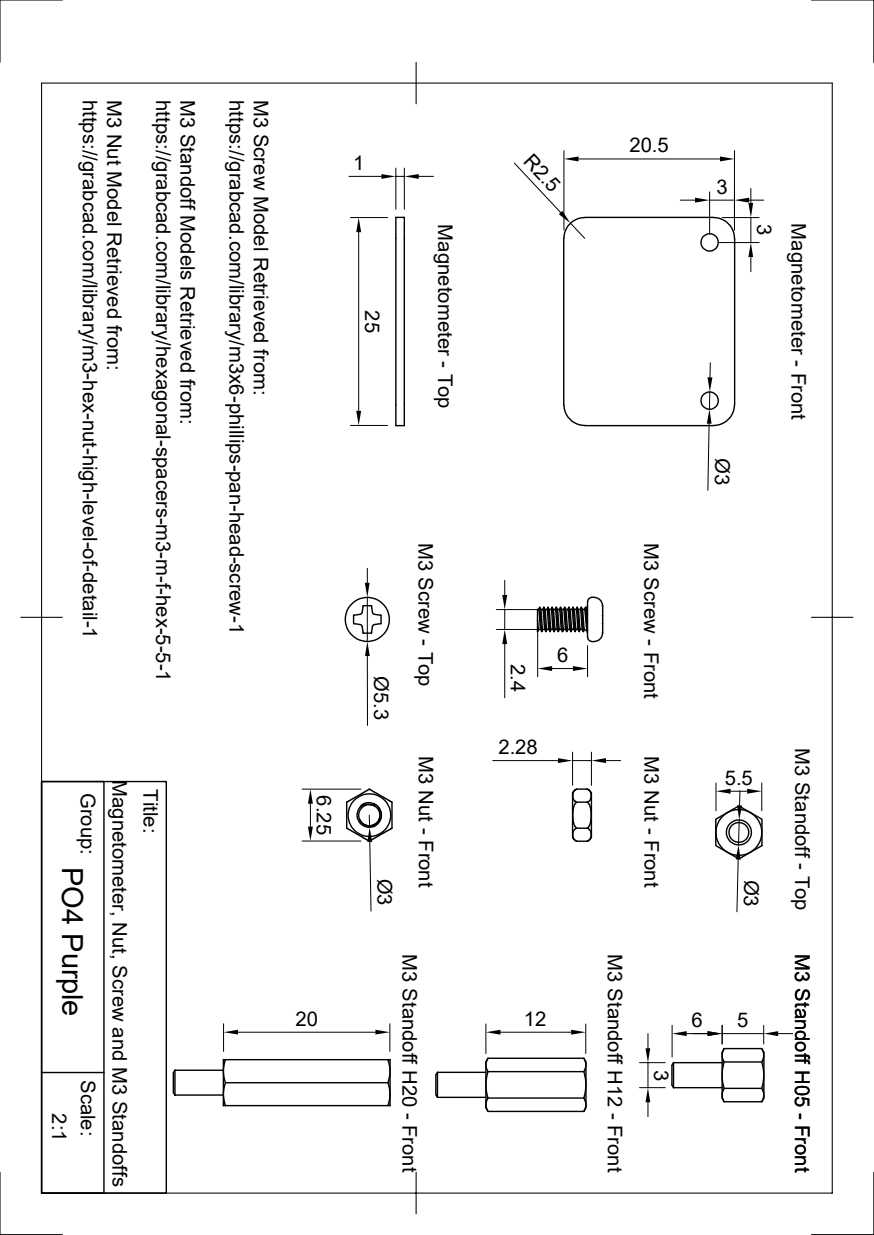
[picture p45: page 1]
3 R2.5 Magnetometer - Top; Magnetometer - Front 2:1; M3 Standoff - Top M3 Standoff H05 - Front M3 Standoff H20 - Front; M3 Standoff H12 - Front; M3 Standoff H05 - Front Magnetometer, Nut, Screw and M3 Standoffs; 6 M3 Screw - Top; M3 Screw - Front M3 Nut - Front; M3 Nut - Front https://grabcad.com/library/m3-hex-nut-high-level-of-detail-1 M3 Nut Model Retrieved from:; https://grabcad.com/library/hexagonal-spacers-m3-m-f-hex-5-5-1 M3 Standoff Models Retrieved from: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

Group: Scale: Title: PO4 Purple Ø3 25 1
