ledwards2/P04-Purple/Demo Day/Marco/Drawings/Drawing_Marking_system.pdf

32 | Servo - Top Servo - Front Servo - Side 14.5 | 4 Ø3 ².5 | 3.5 2 | 3 | 5 R1 | 5

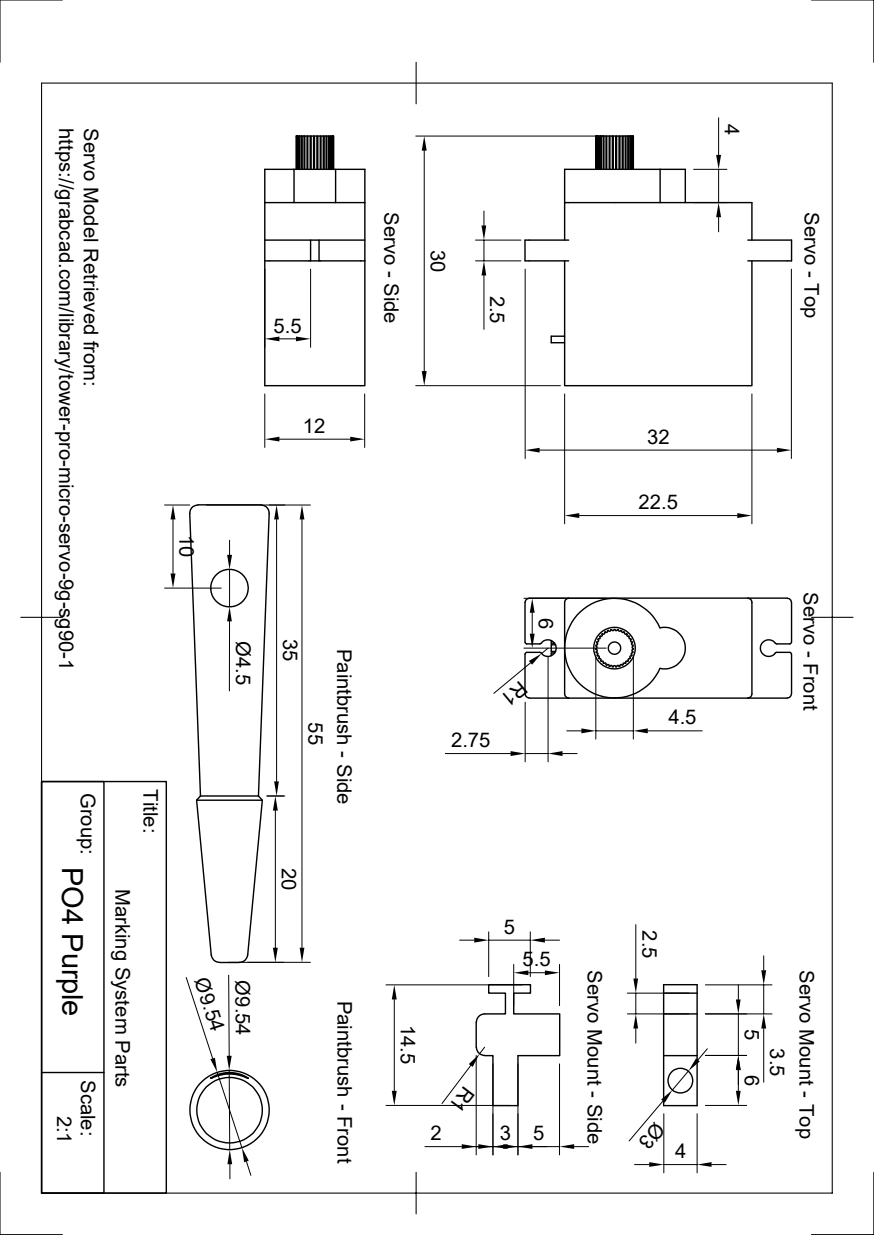
[picture p46: page 1]
5 6 Servo Mount - Side; Servo Mount - Top Marking System Parts 2:1 https://grabcad.com/library/tower-pro-micro-servo-9g-sg90-1 Servo Model Retrieved from:; Paintbrush - Front Paintbrush - Side

Group: Scale: Title: PO4 Purple 30 2.5 4
