ledwards2/P04-Purple/Demo Day/Marco/Drawings/Drawing_Ultrasonic_sensor_system.pdf

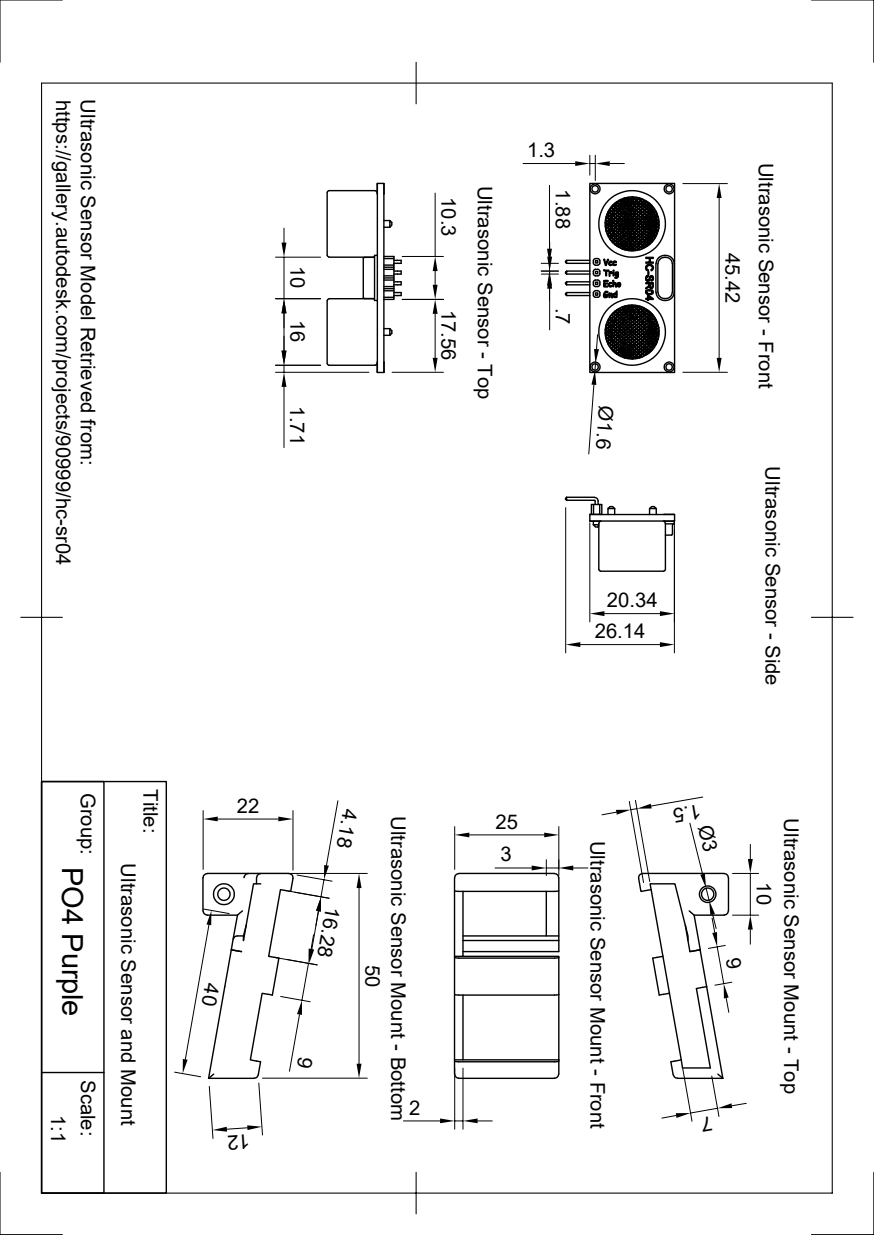
[picture p47: page 1]
Ultrasonic Sensor Mount - Top Ultrasonic Sensor Mount - Front Ultrasonic Sensor Mount - Bottom; Ultrasonic Sensor - Top; Ultrasonic Sensor - Front Ultrasonic Sensor - Side 1:1; Ultrasonic Sensor and Mount https://gallery.autodesk.com/projects/90999/hc-sr04 Ultrasonic Sensor Model Retrieved from:

Group: Scale: Title: PO4 Purple 50 16.28 9
