ledwards2/P04-Purple/Manufactured Componenent/Manufactured Component - Design Drawing.pdf

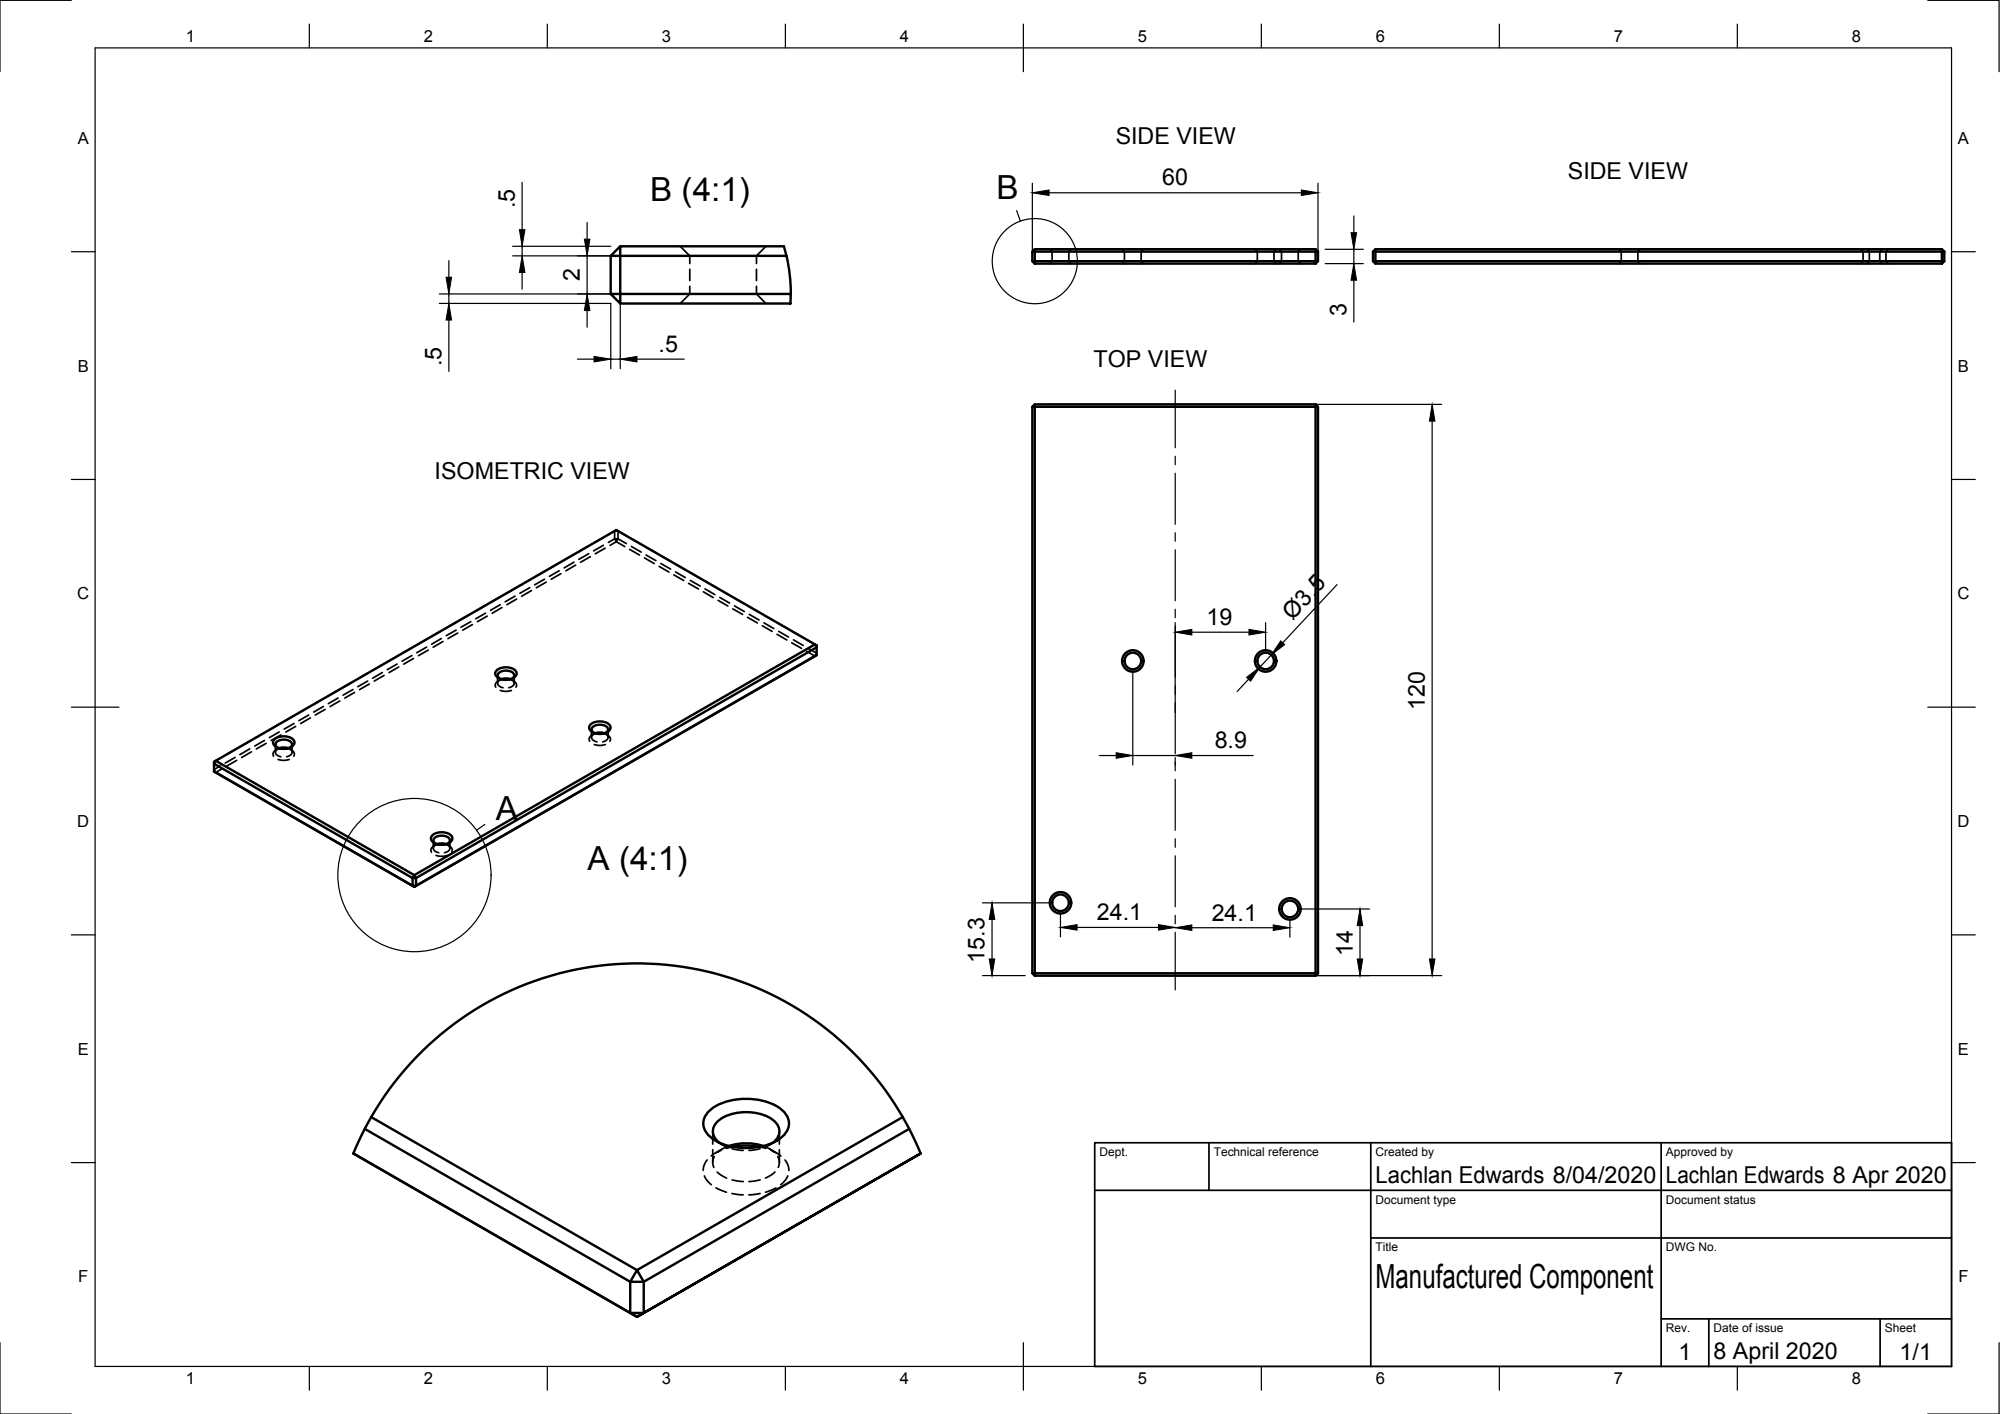
[picture p48: page 1]
TOP VIEW; SIDE VIEW; ISOMETRIC VIEW

Dept. | Technical reference | Created by Lachlan Edwards 8/04/2020 | Approved by Lachlan Edwards 8 Apr 2020

Document type | Document status

Title Manufactured Component | DWG No.

Rev. 1 | Date of issue 8 April 2020 | Sheet 1/1
