ledwards2/P04-Purple/Demo Day/Marco/Drawings/Drawing_Mechanical_Drive_System.pdf

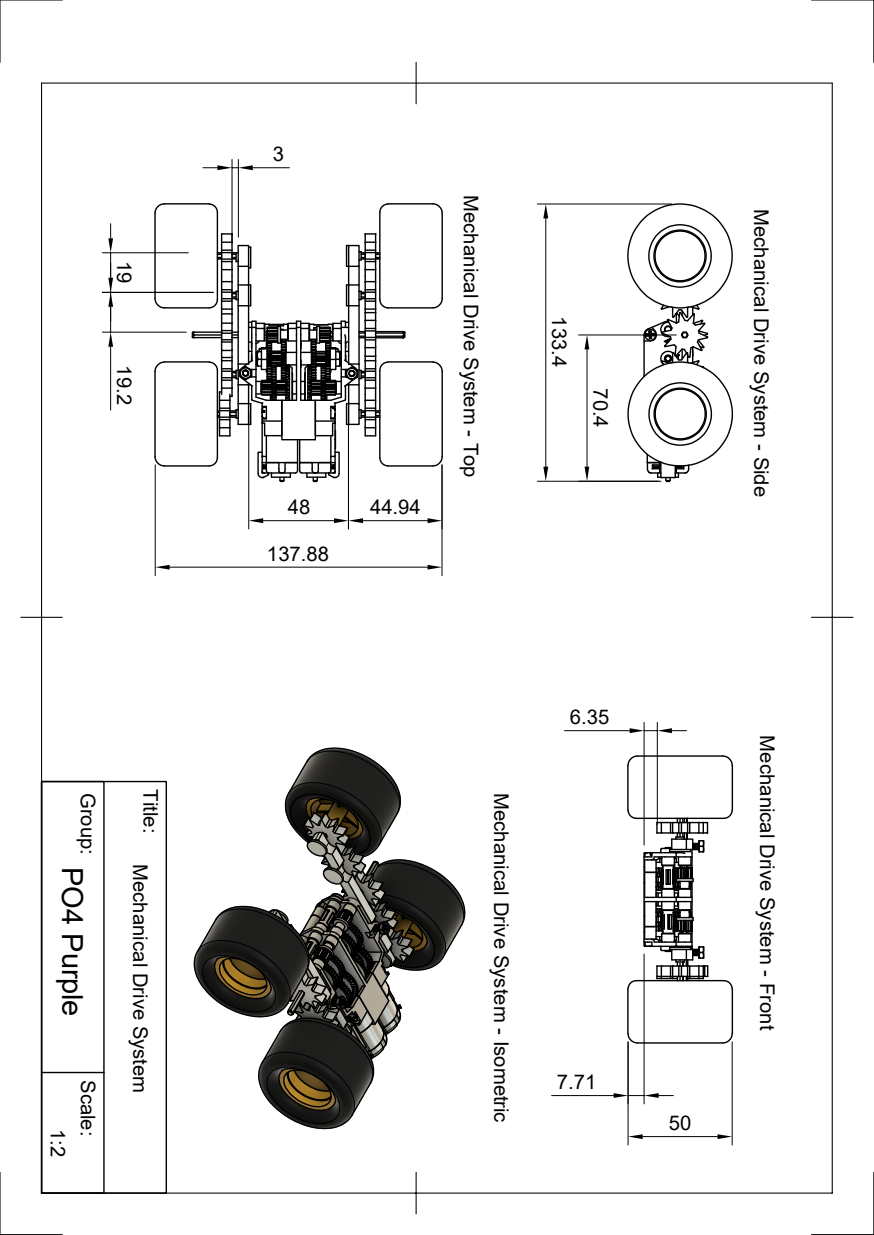
[picture p49: page 1]
6.35 Mechanical Drive System 1:2; Mechanical Drive System - Side Mechanical Drive System - Front Mechanical Drive System - Top Mechanical Drive System - Isometric

Group: Scale: Title: PO4 Purple 19.2 19 3 133.4
