ledwards2/P04-Purple/Demo Day/Marco/Drawings/Drawing_Manufactured_component.pdf

60 | 3 6 | 6 | 5 | 14 15.3 5

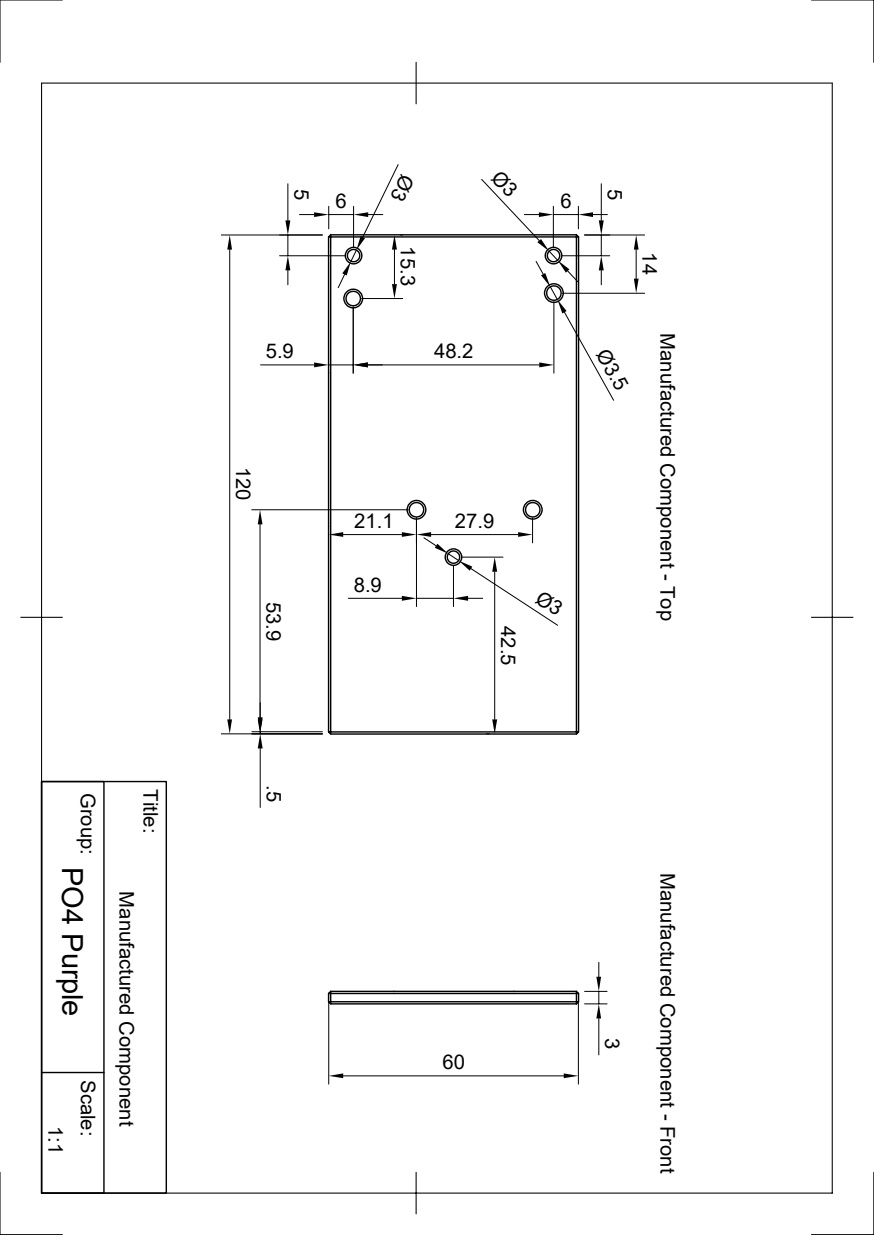
[picture p50: page 1]
42.5 .5 Manufactured Component1:1; Manufactured Component - Top Manufactured Component - Front 53.9

Group: Scale: Title: PO4 Purple 120
