ledwards2/P04-Purple/Demo Day/Marco/Drawings/Drawing_Land_Mine_Marking_System.pdf

55

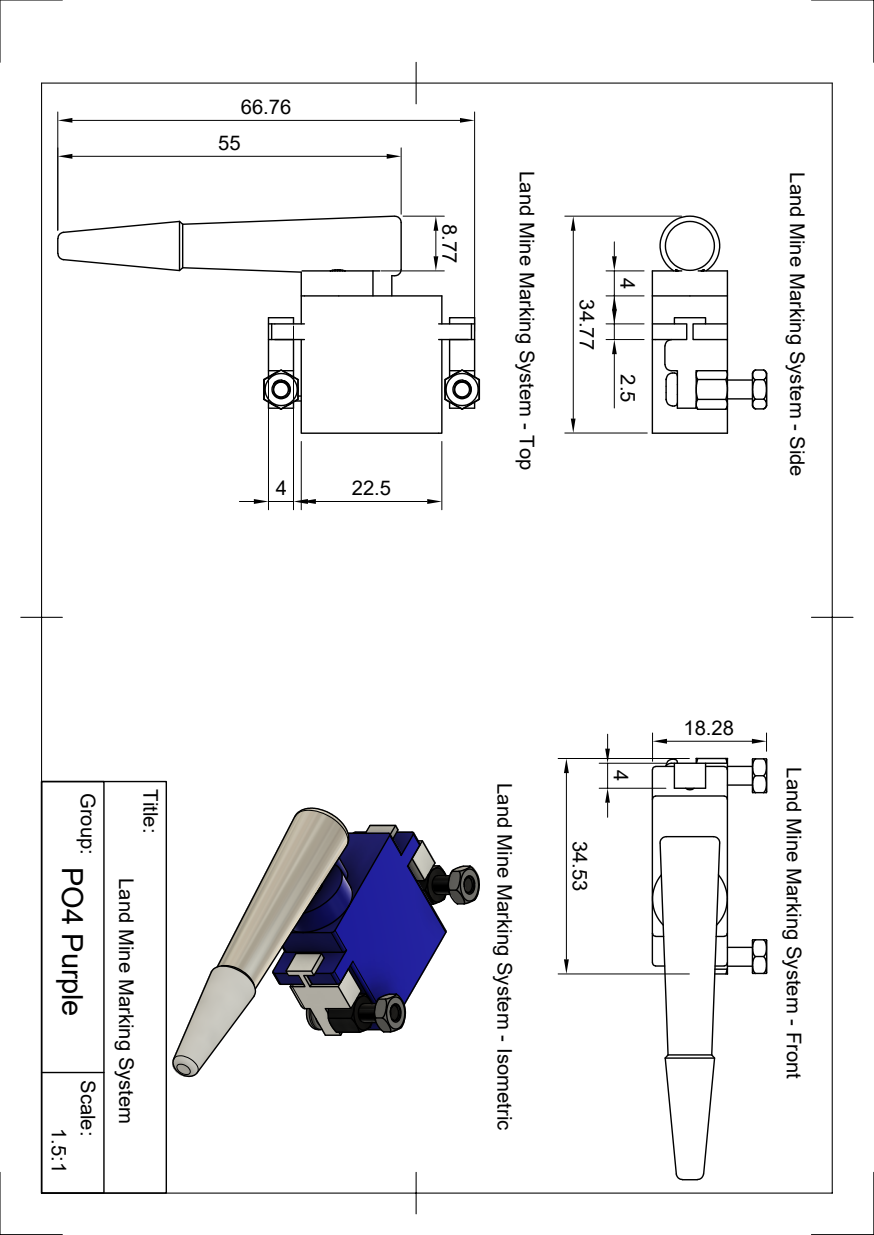
[picture p51: page 1]
Land Mine Marking System - Side Land Mine Marking System - Front Land Mine Marking System - Top Land Mine Marking System - Isometric Land Mine Marking System 1.5:1

Group: Scale: Title: PO4 Purple 34.77
