ledwards2/P04-Purple/(commit log)

2020-04-03 WBS draft upload
    [WBS - 3 Apr.xlsx]
2020-05-05 added control flowchart
2020-05-05 updated main.ino
    modified main code so that sensor conditions are only being checked once per loop cycle, to reduce sensor polling rate, current draw and risk of errors
    [main.ino]
2020-05-05 updated main.ino
    added flashing LED in addition to marking system to fulfill demo day requirements. Modified marking function delays / servo movement speed.
2020-05-05 Add files via upload
    Here are all my drawing I had to do, I was going to draw the different components but it was done already, sorry im not good at cad, if i was I would of liked to do it digitally.
2020-05-23 Modified code to facilitate guided navigation
    Added some functions to resolve vector angles, and started writing guiding script
    [main.ino]
